deagle205/Whoop_1S_FC/Phil_stack_print.stl

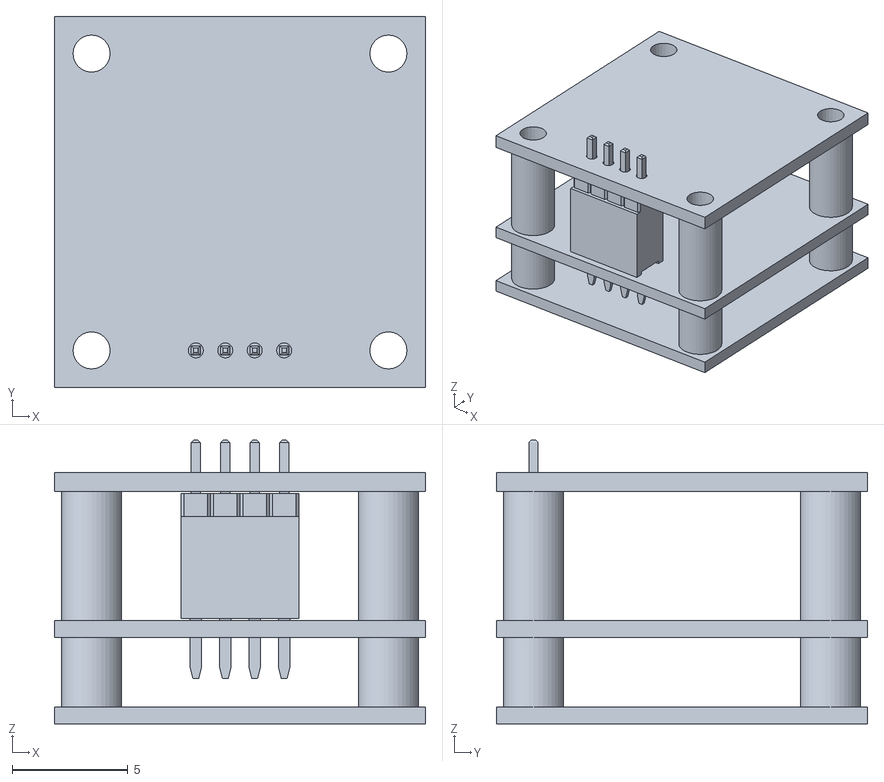
[picture p1: CAD file, 2026-10-23]
Phil_stack_print.stl
16.0 x 16.0 x 12.2
