deagle205/Whoop_1S_FC/Whoop_1S_FC_print.stl

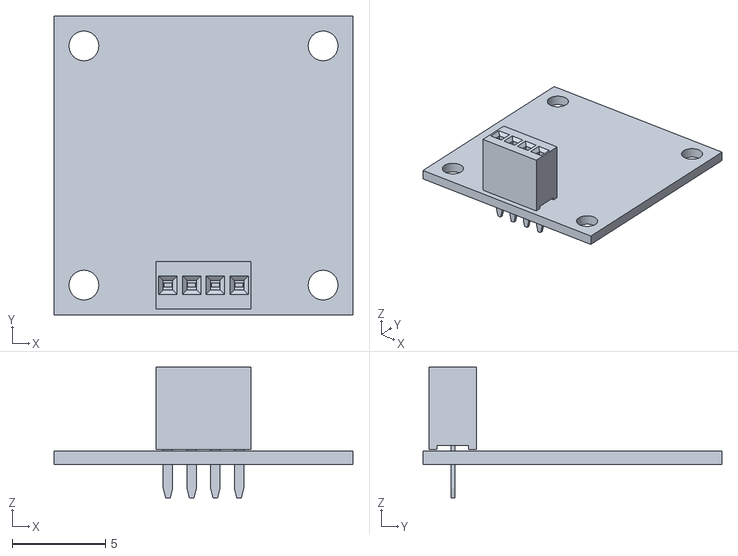
[picture p2: CAD file, 2026-10-23]
Whoop_1S_FC_print.stl
16.0 x 16.0 x 7.00
