deagle205/Whoop_1S_FC/Phil_VTX/Phil_VTX.kicad_pcb

## KiCad design Phil_VTX/Phil_VTX.kicad_pcb (2026-10-23)

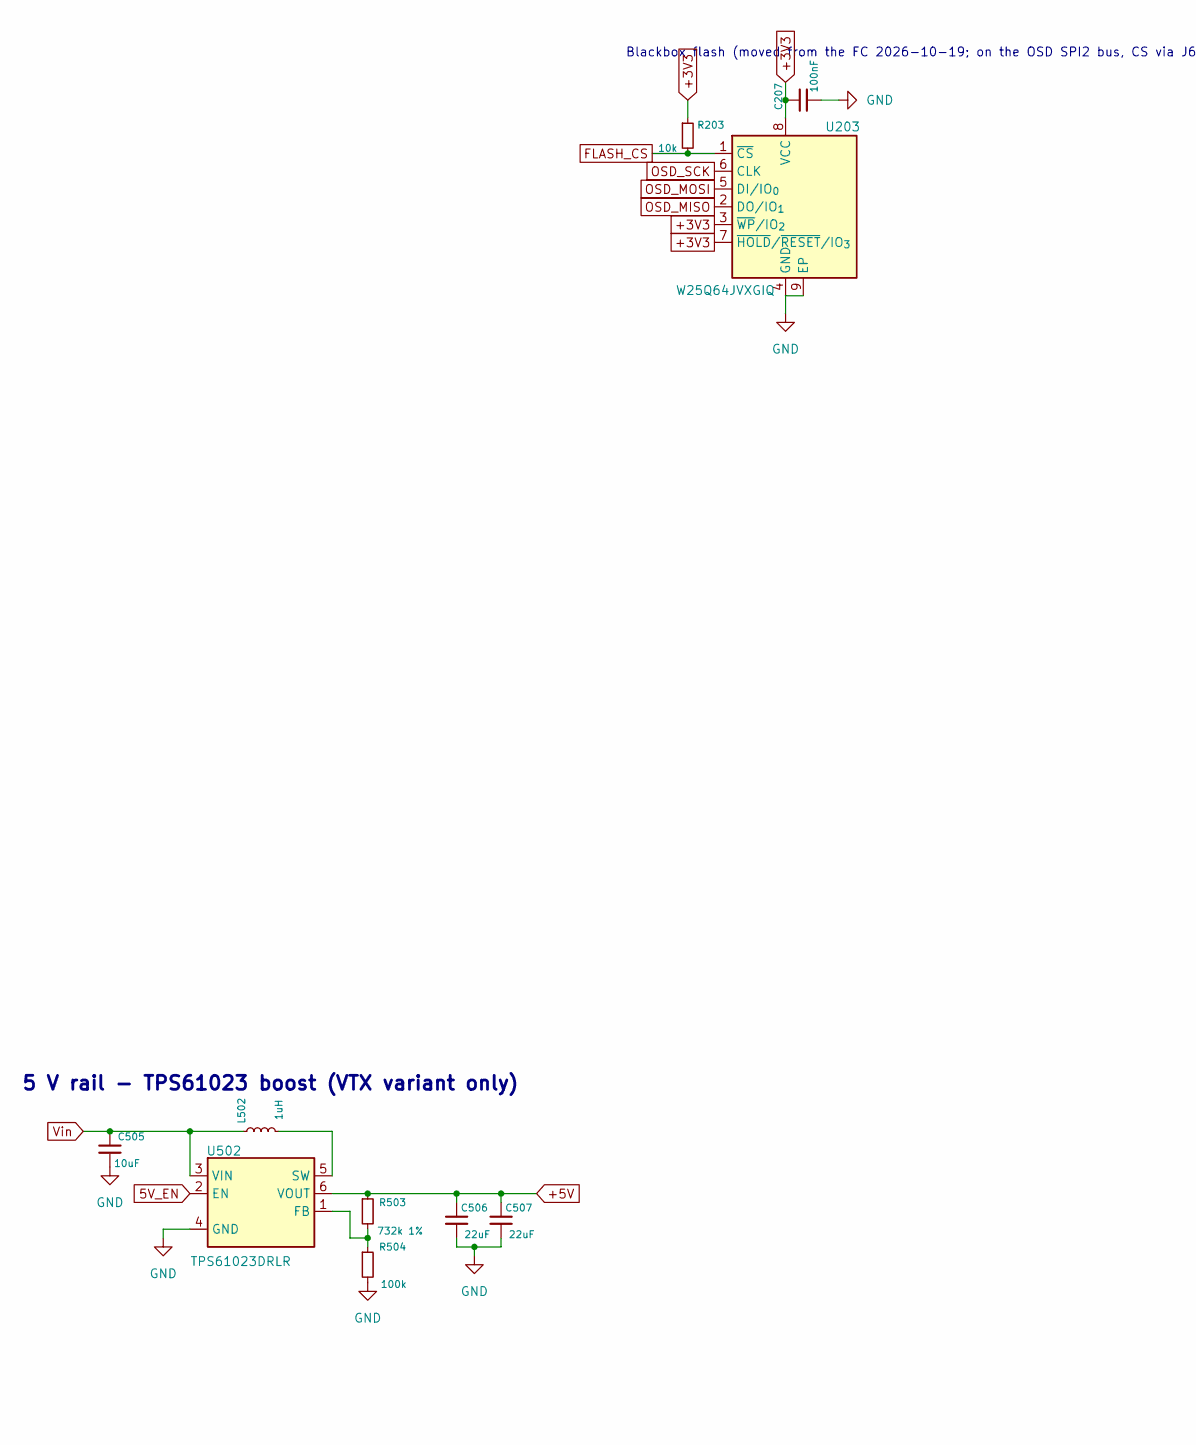
[picture p3: schematic Phil_VTX.kicad_sch, Phil VTX board (5.8 GHz VTX + OSD), part in row 1, column 1]

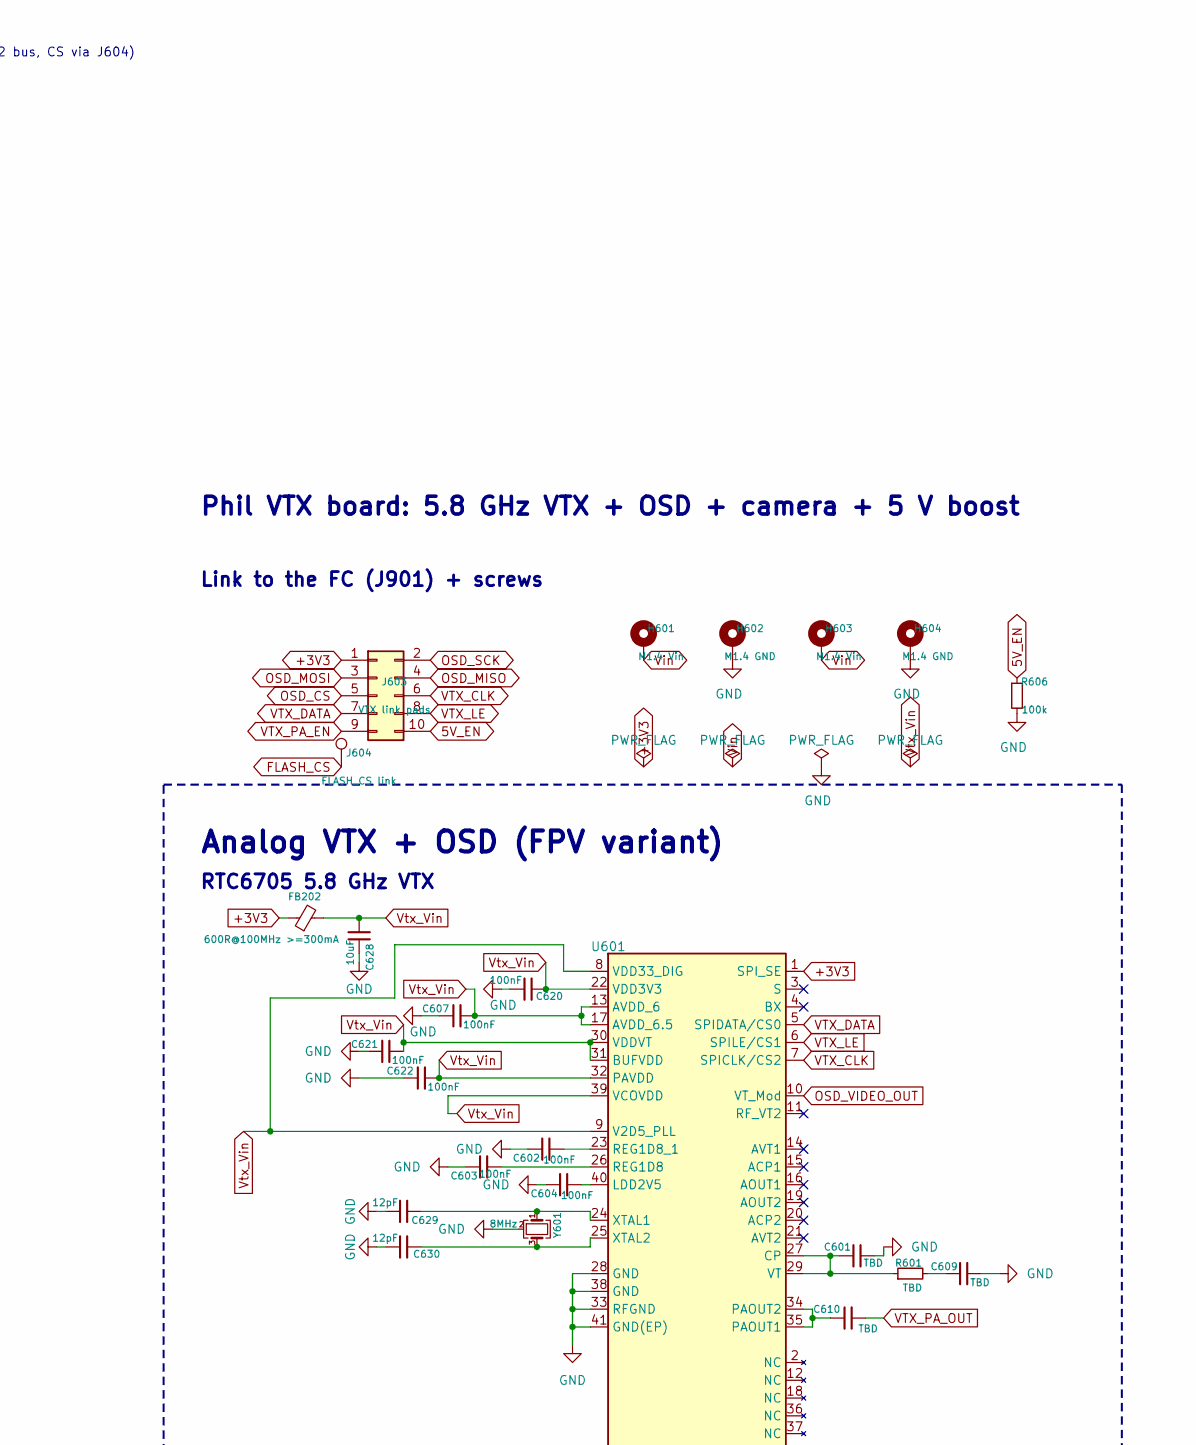
[picture p4: schematic Phil_VTX.kicad_sch, Phil VTX board (5.8 GHz VTX + OSD), part in row 1, column 2]

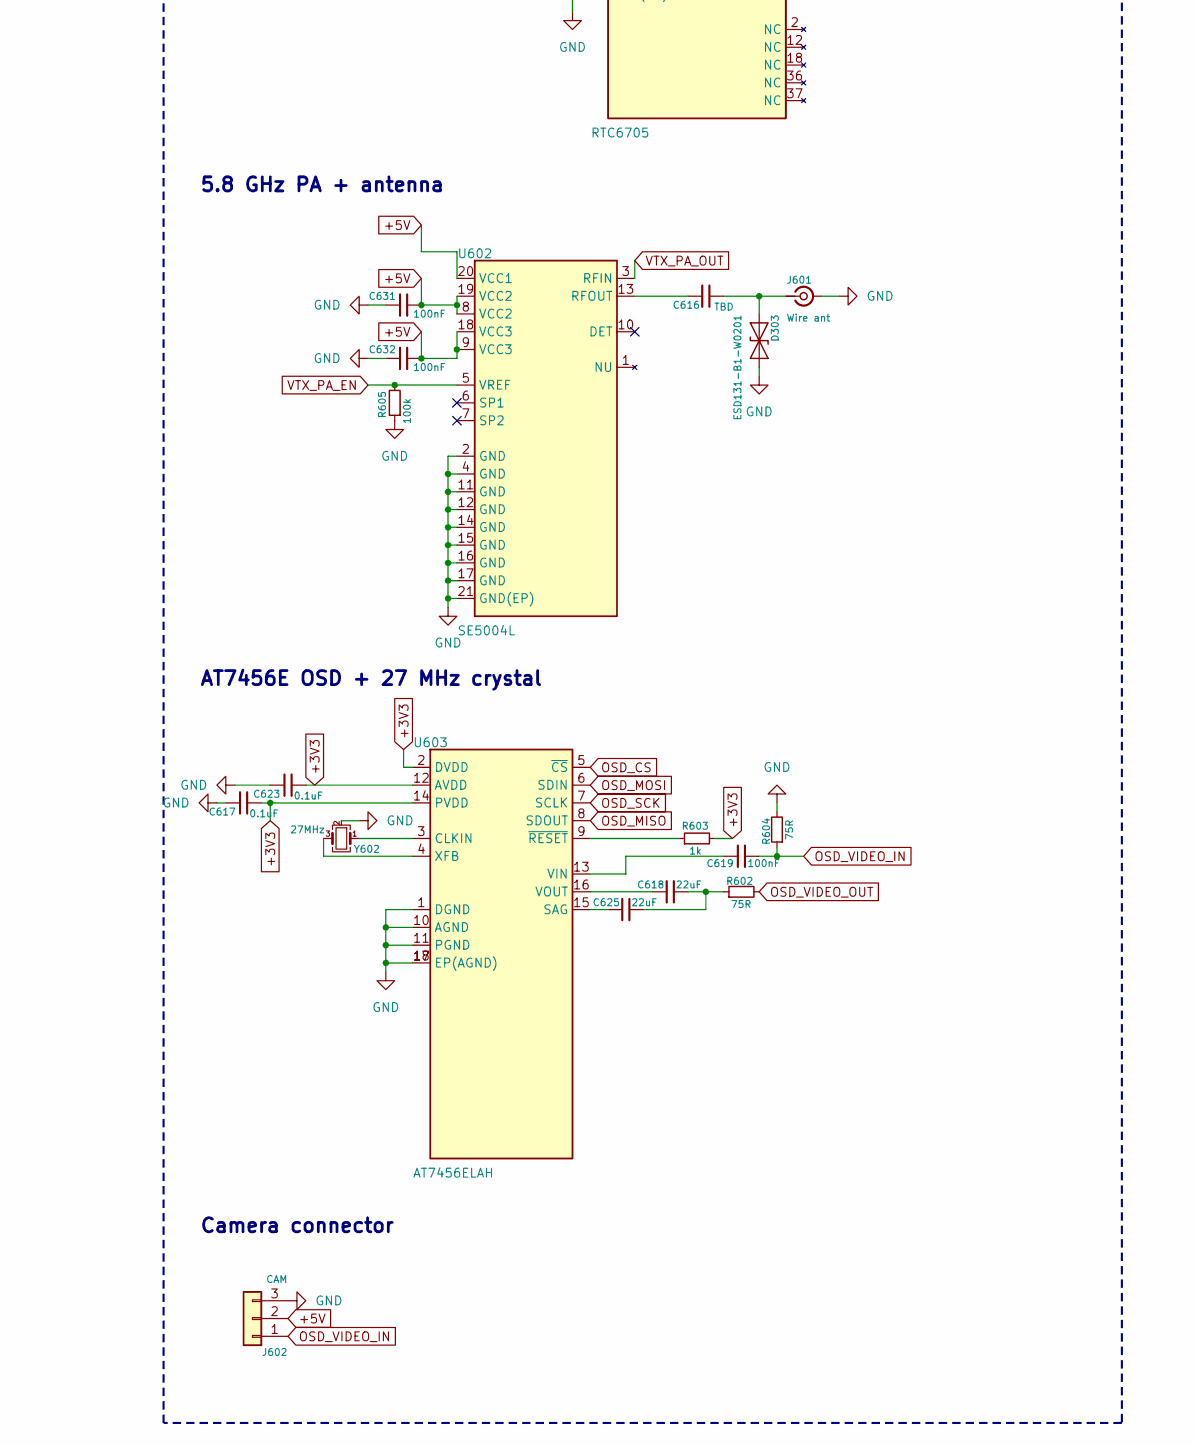
[picture p5: schematic Phil_VTX.kicad_sch, Phil VTX board (5.8 GHz VTX + OSD), part in row 2, column 2]

Parts:
C207, C602, C603, C604, C607, C619, C620, C621, C622, C631, C632: 100nF; C_0201_0603Metric; MPN CL03A104KQ3NNNC; LCSC C160831
C505, C628: 10uF; C_0603_1608Metric; MPN CL10A106KP8NNNC; LCSC C19702
C506, C507, C618, C625: 22uF; C_0603_1608Metric; MPN CL10A226MP8NUNE; LCSC C86295
C601, C609, C610, C616: TBD; C_0201_0603Metric
C617, C623: 0.1uF; C_0201_0603Metric; MPN CL03A104KQ3NNNC; LCSC C160831
C629, C630: 12pF; C_0201_0603Metric; MPN GRM0335C1H120JA01D; LCSC C85890
D303: ESD131-B1-W0201; Infineon_SG-WLL-2-3_0.58x0.28_P0.36mm; MPN ESD131-B1-W0201
FB202: 600R@100MHz >=300mA; L_0603_1608Metric
H601, H603: M1.4 Vin; MountingHole_1.6mm_M1.4_Pad_2.6mm
H602, H604: M1.4 GND; MountingHole_1.6mm_M1.4_Pad_2.6mm
J601: Wire ant; Antenna_Wire_Hole_D0.6mm
J602: CAM; Pads_1x03_P2.0mm_1.5x2.0mm; MPN SM03B-SRSS-TB
J603: VTX link pads; Pads_2x05_P1.8mm_1.5x2.0mm_Mirrored
J604: FLASH_CS link; TP_Wire_1.5x2.0mm
L502: 1uH; L_Murata_DFE201610P
R203: 10k; R_0201_0603Metric; MPN RC0201FR-0710KL; LCSC C106225
R503: 732k 1%; R_0201_0603Metric; MPN AA0201FR-07732KL; LCSC C2106378
R504, R605, R606: 100k; R_0201_0603Metric; MPN 0201WMF1003TEE; LCSC C270364
R601: TBD; R_0201_0603Metric
R602, R604: 75R; R_0201_0603Metric; MPN 0201WMF750JTCE; LCSC C270688
R603: 1k; R_0201_0603Metric; MPN 0201WMF1001TEE; LCSC C270365
U203: W25Q64JVXGIQ; Winbond_XSON-8-1EP_4x4mm_P0.8mm_EP2.3x3mm; MPN W25Q64JVXGIQ
U502: TPS61023DRLR; SOT-563; MPN TPS61023DRLR
U601: RTC6705; QFN-40-1EP_6x6mm_P0.5mm_EP4.6x4.6mm; MPN RTC6705
U602: SE5004L; QFN-20-1EP_4x4mm_P0.5mm_EP2.5x2.5mm; MPN SE5004L
U603: AT7456ELAH; AT7456E_LGA-16_4x6.8mm_P0.65mm; MPN AT7456E
Y601: 8MHz; Crystal_SMD_2016-4Pin_2.0x1.6mm
Y602: 27MHz; Crystal_SMD_WE_IQXC-26-4Pin_1.6x1.2mm

Connections:
5V_EN: J603.10, R606.1, U502.2 (EN)
+3V3: C207.1, C617.2, C623.2, FB202.1, J603.1, R203.1, R603.2, U203.3 (~WP/IO_{2}), U203.7 (~HOLD/~RESET/IO_{3}), U203.8 (VCC), U601.1 (SPI_SE), U603.2 (DVDD), U603.12 (AVDD), U603.14 (PVDD)
+5V: C506.1, C507.1, C631.2, C632.2, J602.2, R503.1, U502.6 (VOUT), U602.8 (VCC2), U602.9 (VCC3), U602.18 (VCC3), U602.19 (VCC2), U602.20 (VCC1)
GND: C207.2, C505.2, C506.2, C507.2, C601.2, C602.1, C603.1, C604.1, C607.1, C609.2, C617.1, C620.2, C621.1, C622.1, C623.1, C628.2, C629.2, C630.2, C631.1, C632.1, D303.2 (A2), H602.1, H604.1, J601.2 (Ext), J602.3, R504.2, R604.2, R605.1, R606.2, U203.4 (GND), U203.9 (EP), U502.4 (GND), U601.28 (GND), U601.33 (RFGND), U601.38 (GND), U601.41 (GND(EP)), U602.2 (GND), U602.4 (GND), U602.11 (GND), U602.12 (GND), U602.14 (GND), U602.15 (GND), U602.16 (GND), U602.17 (GND), U602.21 (GND(EP)), U603.1 (DGND), U603.10 (AGND), U603.11 (PGND), U603.17 (EP(AGND)), U603.18 (EP(AGND)), Y601.2 (G), Y601.4 (G), Y602.2 (G), Y602.4 (G)
unnamed: C609.1, R601.2
unnamed: C618.2, C625.2, R602.1
unnamed: C616.2, D303.1 (A1), J601.1 (In)
unnamed: J604.1, R203.2, U203.1 (~CS)
unnamed: R503.2, R504.1, U502.1 (FB)
unnamed: L502.2, U502.5 (SW)
unnamed: C601.1, R601.1, U601.27 (CP), U601.29 (VT)
unnamed: C604.2, U601.40 (LDD2V5)
unnamed: C610.1, U601.34 (PAOUT2), U601.35 (PAOUT1)
unnamed: C603.2, U601.26 (REG1D8)
unnamed: C602.2, U601.23 (REG1D8_1)
unnamed: C629.1, U601.24 (XTAL1), Y601.1
unnamed: C630.1, U601.25 (XTAL2), Y601.3
unnamed: C616.1, U602.13 (RFOUT)
unnamed: U603.3 (CLKIN), Y602.1
unnamed: C625.1, U603.15 (SAG)
unnamed: C619.1, U603.13 (VIN)
unnamed: C618.1, U603.16 (VOUT)
unnamed: U603.4 (XFB), Y602.3
unnamed: R603.1, U603.9 (~RESET)
OSD_CS: J603.5, U603.5 (~CS)
OSD_MISO: J603.4, U203.2 (DO/IO_{1}), U603.8 (SDOUT)
OSD_MOSI: J603.3, U203.5 (DI/IO_{0}), U603.6 (SDIN)
OSD_SCK: J603.2, U203.6 (CLK), U603.7 (SCLK)
OSD_VIDEO_IN: C619.2, J602.1, R604.1
OSD_VIDEO_OUT: R602.2, U601.10 (VT_Mod)
VTX_CLK: J603.6, U601.7 (SPICLK/CS2)
VTX_DATA: J603.7, U601.5 (SPIDATA/CS0)
VTX_LE: J603.8, U601.6 (SPILE/CS1)
VTX_PA_EN: J603.9, R605.2, U602.5 (VREF)
VTX_PA_OUT: C610.2, U602.3 (RFIN)
Vin: C505.1, H601.1, H603.1, L502.1, U502.3 (VIN)
Vtx_Vin: C607.2, C620.1, C621.2, C622.2, C628.1, FB202.2, U601.8 (VDD33_DIG), U601.9 (V2D5_PLL), U601.13 (AVDD_6), U601.17 (AVDD_6.5), U601.22 (VDD3V3), U601.30 (VDDVT), U601.31 (BUFVDD), U601.32 (PAVDD), U601.39 (VCOVDD)

Notes on the sheet:
5 V rail - TPS61023 boost (VTX variant only)
5.8 GHz PA + antenna
RTC6705 5.8 GHz VTX
Blackbox flash (moved from the FC 2026-10-19; on the OSD SPI2 bus, CS via J604)
Phil VTX board: 5.8 GHz VTX + OSD + camera + 5 V boost
Link to the FC (J901) + screws
AT7456E OSD + 27 MHz crystal
Camera connector
Analog VTX + OSD (FPV variant)

Board: 6 copper layers, 48 parts (0 on the bottom side), 36 nets, no tracks yet.
