deagle205/Whoop_1S_FC/Phil_ESC/Phil_ESC.kicad_pcb

## KiCad design Phil_ESC/Phil_ESC.kicad_pcb (2026-10-23)

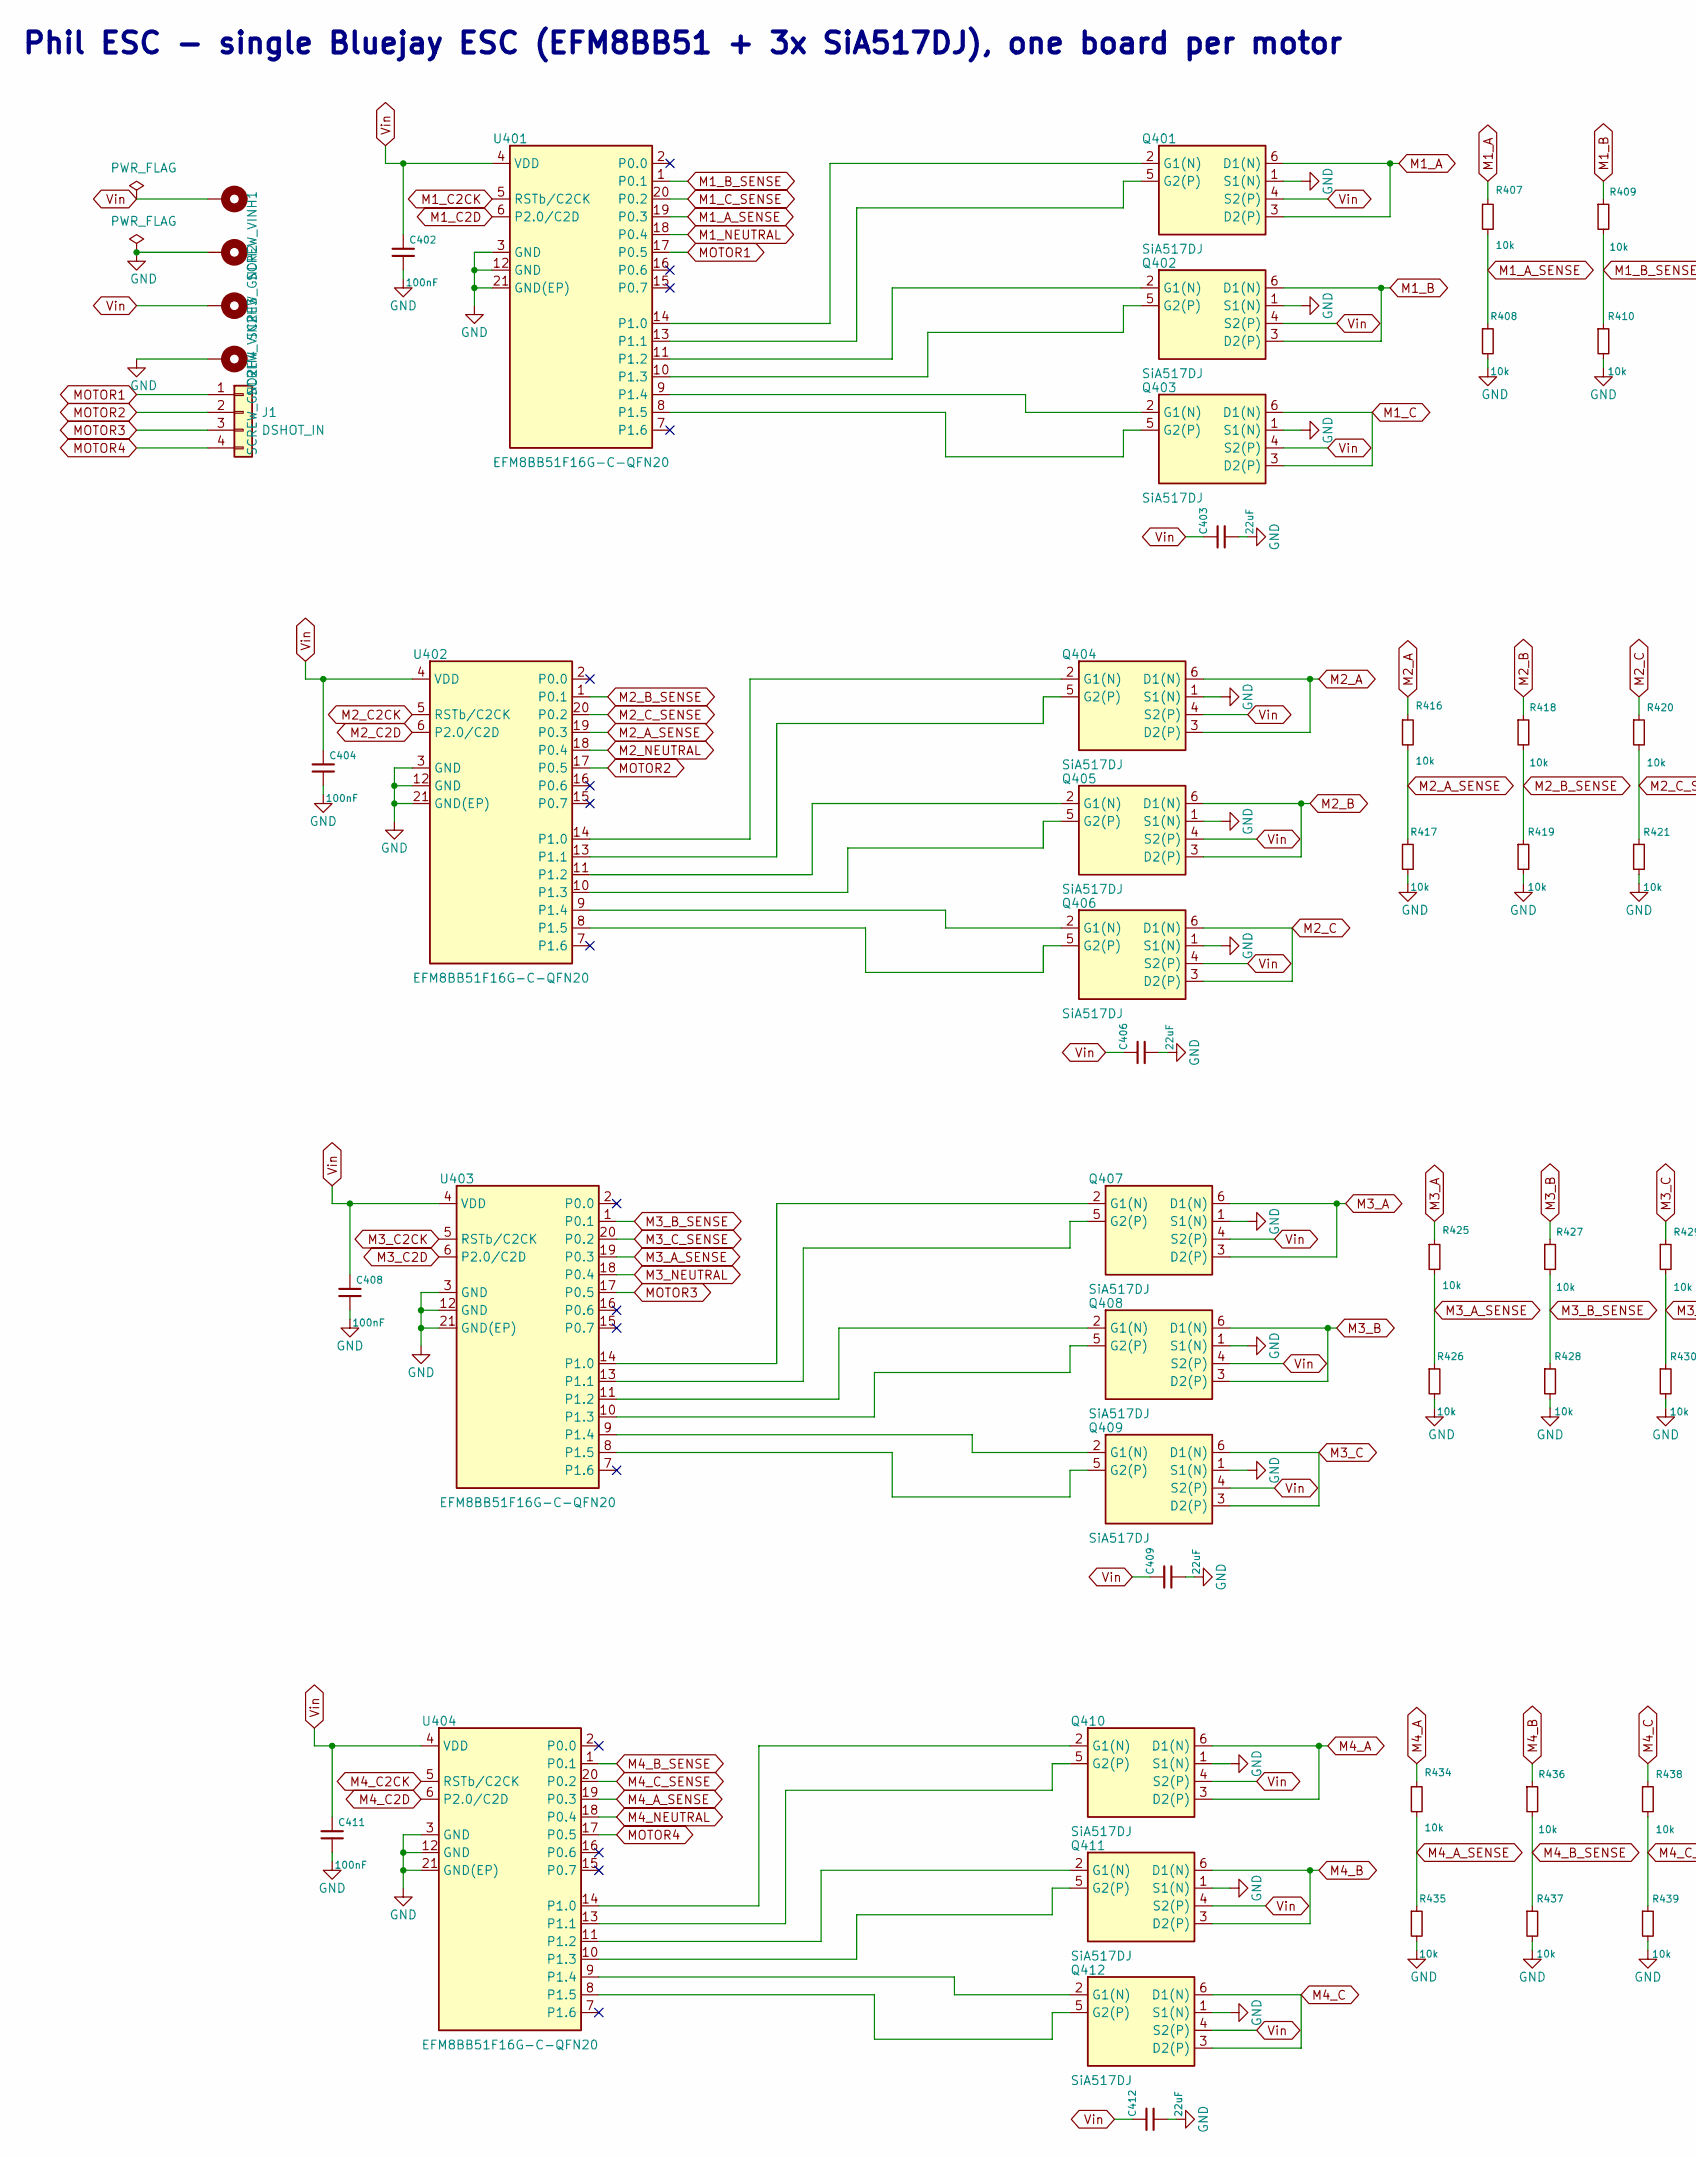
[picture p6: schematic Phil_ESC.kicad_sch, Phil ESC - single-motor Bluejay ESC, part in row 1, column 1]

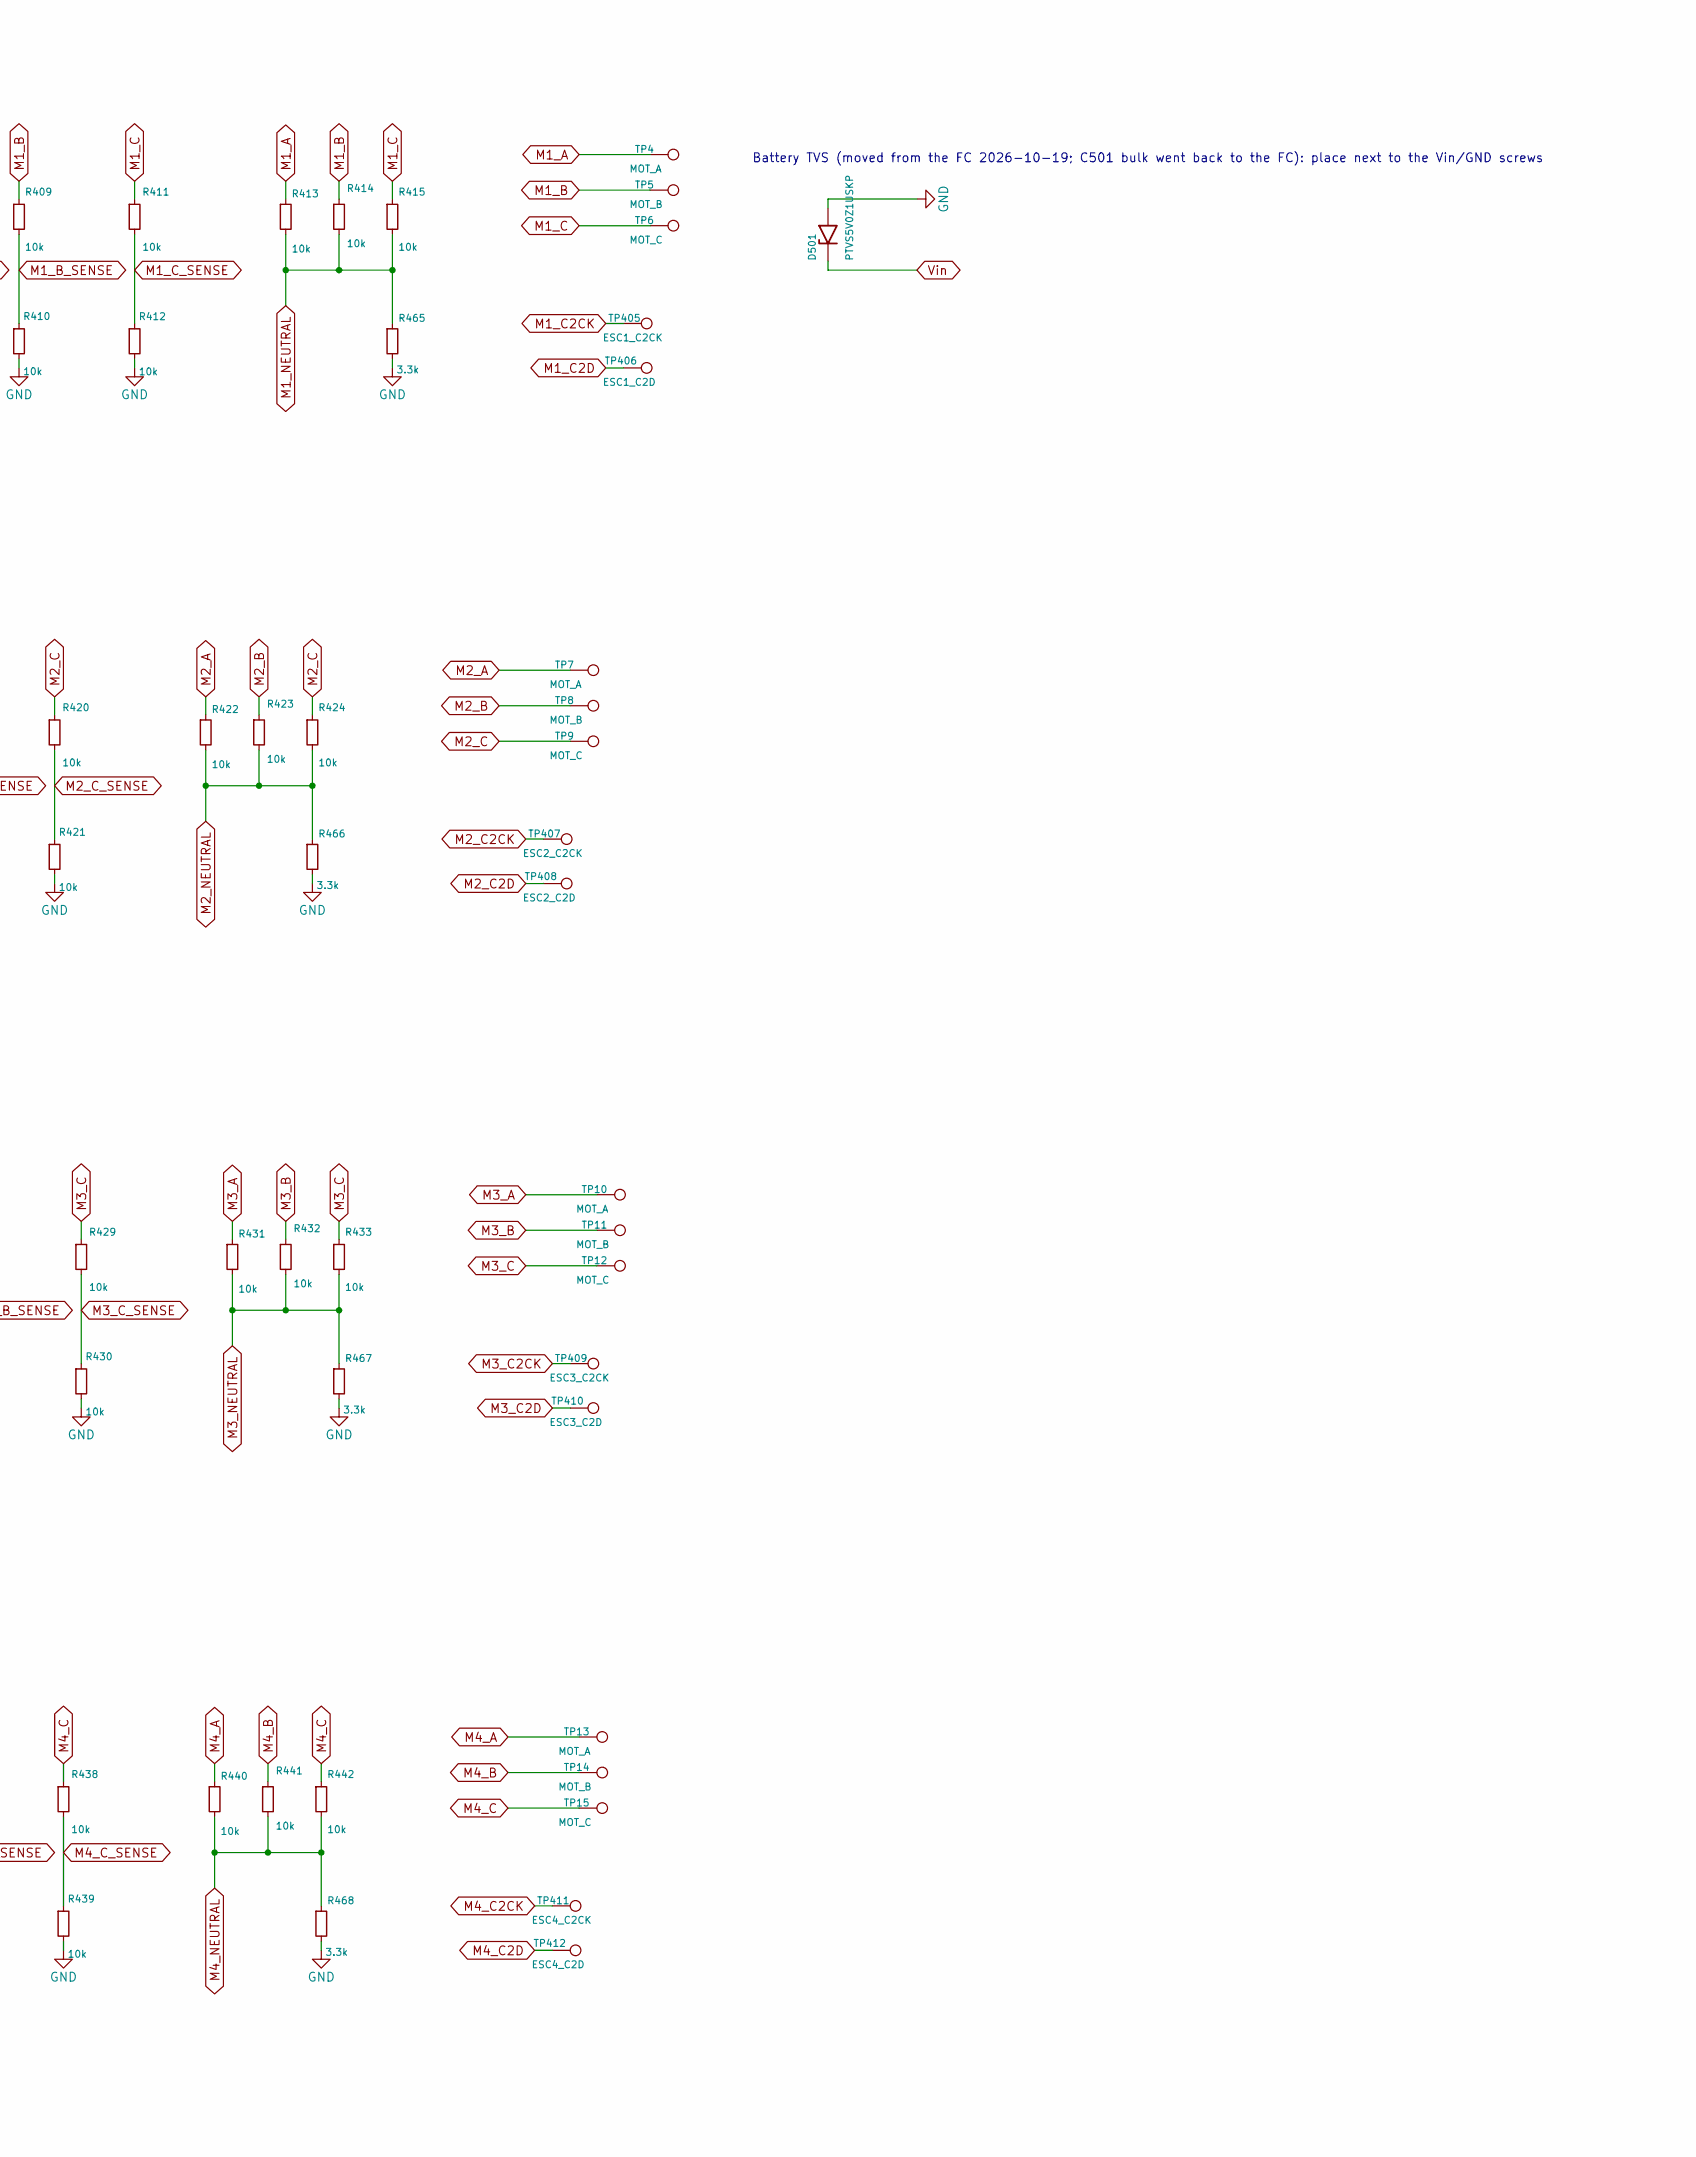
[picture p7: schematic Phil_ESC.kicad_sch, Phil ESC - single-motor Bluejay ESC, part in row 1, column 2]

Parts:
C402, C404, C408, C411: 100nF; C_0201_0603Metric; MPN CL03A104KQ3NNNC; LCSC C160831
C403, C406, C409, C412: 22uF; C_0603_1608Metric; MPN CL10A226MP8NUNE; LCSC C86295
D501: PTVS5V0Z1USKP; Nexperia_DSN1608-2_1.6x0.8mm; MPN PTVS5V0Z1USKP
H1: SCREW_VIN; MountingHole_1.6mm_M1.4_Pad_2.6mm
H2: SCREW_GND; MountingHole_1.6mm_M1.4_Pad_2.6mm
H3: SCREW_VIN2; MountingHole_1.6mm_M1.4_Pad_2.6mm
H4: SCREW_GND2; MountingHole_1.6mm_M1.4_Pad_2.6mm
J1: DSHOT_IN; PinHeader_1x04_P1.27mm_Vertical
Q401, Q402, Q403, Q404, Q405, Q406, Q407, Q408, Q409, Q410, Q411, Q412: SiA517DJ; Vishay_PowerPAK_SC70-6L_Dual; MPN SIA517DJ-T1-GE3
R407, R408, R409, R410, R411, R412, R413, R414, R415, R416, R417, R418, R419, R420, R421, R422, R423, R424, R425, R426, R427, R428, R429, R430, R431, R432, R433, R434, R435, R436, R437, R438, R439, R440, R441, R442: 10k; R_0201_0603Metric; MPN RC0201FR-0710KL; LCSC C106225
R465, R466, R467, R468: 3.3k; R_0201_0603Metric; MPN RC0201FR-073K3L; LCSC C274874
TP4, TP7, TP10, TP13: MOT_A; TP_Motor_1.5x1.5mm
TP5, TP8, TP11, TP14: MOT_B; TP_Motor_1.5x1.5mm
TP6, TP9, TP12, TP15: MOT_C; TP_Motor_1.5x1.5mm
TP405: ESC1_C2CK; TP_Probe_D0.6mm
TP406: ESC1_C2D; TP_Probe_D0.6mm
TP407: ESC2_C2CK; TP_Probe_D0.6mm
TP408: ESC2_C2D; TP_Probe_D0.6mm
TP409: ESC3_C2CK; TP_Probe_D0.6mm
TP410: ESC3_C2D; TP_Probe_D0.6mm
TP411: ESC4_C2CK; TP_Probe_D0.6mm
TP412: ESC4_C2D; TP_Probe_D0.6mm
U401, U402, U403, U404: EFM8BB51F16G-C-QFN20; SiliconLabs_QFN-20-1EP_3x3mm_P0.5mm_EP1.8x1.8mm; MPN EFM8BB51F16G-C-QFN20

Connections:
GND: C402.2, C403.2, C404.2, C406.2, C408.2, C409.2, C411.2, C412.2, D501.2 (A2), H2.1 (1_1), H4.1 (1_1), Q401.1 (S1(N)), Q402.1 (S1(N)), Q403.1 (S1(N)), Q404.1 (S1(N)), Q405.1 (S1(N)), Q406.1 (S1(N)), Q407.1 (S1(N)), Q408.1 (S1(N)), Q409.1 (S1(N)), Q410.1 (S1(N)), Q411.1 (S1(N)), Q412.1 (S1(N)), R408.2, R410.2, R412.2, R417.2, R419.2, R421.2, R426.2, R428.2, R430.2, R435.2, R437.2, R439.2, R465.2, R466.2, R467.2, R468.2, U401.3 (GND), U401.12 (GND), U401.21 (GND(EP)), U402.3 (GND), U402.12 (GND), U402.21 (GND(EP)), U403.3 (GND), U403.12 (GND), U403.21 (GND(EP)), U404.3 (GND), U404.12 (GND), U404.21 (GND(EP))
M1_A: Q401.3 (D2(P)), Q401.6 (D1(N)), R407.1, R413.1, TP4.1 (1_1)
M1_A_SENSE: R407.2, R408.1, U401.19 (P0.3)
M1_B: Q402.3 (D2(P)), Q402.6 (D1(N)), R409.1, R414.1, TP5.1 (1_1)
M1_B_SENSE: R409.2, R410.1, U401.1 (P0.1)
M1_C: Q403.3 (D2(P)), Q403.6 (D1(N)), R411.1, R415.1, TP6.1 (1_1)
M1_C2CK: TP405.1 (1_1), U401.5 (RSTb/C2CK)
M1_C2D: TP406.1 (1_1), U401.6 (P2.0/C2D)
M1_C_SENSE: R411.2, R412.1, U401.20 (P0.2)
M1_NEUTRAL: R413.2, R414.2, R415.2, R465.1, U401.18 (P0.4)
M2_A: Q404.3 (D2(P)), Q404.6 (D1(N)), R416.1, R422.1, TP7.1 (1_1)
M2_A_SENSE: R416.2, R417.1, U402.19 (P0.3)
M2_B: Q405.3 (D2(P)), Q405.6 (D1(N)), R418.1, R423.1, TP8.1 (1_1)
M2_B_SENSE: R418.2, R419.1, U402.1 (P0.1)
M2_C: Q406.3 (D2(P)), Q406.6 (D1(N)), R420.1, R424.1, TP9.1 (1_1)
M2_C2CK: TP407.1 (1_1), U402.5 (RSTb/C2CK)
M2_C2D: TP408.1 (1_1), U402.6 (P2.0/C2D)
M2_C_SENSE: R420.2, R421.1, U402.20 (P0.2)
M2_NEUTRAL: R422.2, R423.2, R424.2, R466.1, U402.18 (P0.4)
M3_A: Q407.3 (D2(P)), Q407.6 (D1(N)), R425.1, R431.1, TP10.1 (1_1)
M3_A_SENSE: R425.2, R426.1, U403.19 (P0.3)
M3_B: Q408.3 (D2(P)), Q408.6 (D1(N)), R427.1, R432.1, TP11.1 (1_1)
M3_B_SENSE: R427.2, R428.1, U403.1 (P0.1)
M3_C: Q409.3 (D2(P)), Q409.6 (D1(N)), R429.1, R433.1, TP12.1 (1_1)
M3_C2CK: TP409.1 (1_1), U403.5 (RSTb/C2CK)
M3_C2D: TP410.1 (1_1), U403.6 (P2.0/C2D)
M3_C_SENSE: R429.2, R430.1, U403.20 (P0.2)
M3_NEUTRAL: R431.2, R432.2, R433.2, R467.1, U403.18 (P0.4)
M4_A: Q410.3 (D2(P)), Q410.6 (D1(N)), R434.1, R440.1, TP13.1 (1_1)
M4_A_SENSE: R434.2, R435.1, U404.19 (P0.3)
M4_B: Q411.3 (D2(P)), Q411.6 (D1(N)), R436.1, R441.1, TP14.1 (1_1)
M4_B_SENSE: R436.2, R437.1, U404.1 (P0.1)
M4_C: Q412.3 (D2(P)), Q412.6 (D1(N)), R438.1, R442.1, TP15.1 (1_1)
M4_C2CK: TP411.1 (1_1), U404.5 (RSTb/C2CK)
M4_C2D: TP412.1 (1_1), U404.6 (P2.0/C2D)
M4_C_SENSE: R438.2, R439.1, U404.20 (P0.2)
M4_NEUTRAL: R440.2, R441.2, R442.2, R468.1, U404.18 (P0.4)
MOTOR1: J1.1, U401.17 (P0.5)
MOTOR2: J1.2, U402.17 (P0.5)
MOTOR3: J1.3, U403.17 (P0.5)
MOTOR4: J1.4, U404.17 (P0.5)
unnamed: Q401.2 (G1(N)), U401.14 (P1.0)
unnamed: Q401.5 (G2(P)), U401.13 (P1.1)
unnamed: Q402.2 (G1(N)), U401.11 (P1.2)
unnamed: Q402.5 (G2(P)), U401.10 (P1.3)
unnamed: Q403.2 (G1(N)), U401.9 (P1.4)
unnamed: Q403.5 (G2(P)), U401.8 (P1.5)
unnamed: Q404.2 (G1(N)), U402.14 (P1.0)
unnamed: Q404.5 (G2(P)), U402.13 (P1.1)
unnamed: Q405.2 (G1(N)), U402.11 (P1.2)
unnamed: Q405.5 (G2(P)), U402.10 (P1.3)
unnamed: Q406.2 (G1(N)), U402.9 (P1.4)
unnamed: Q406.5 (G2(P)), U402.8 (P1.5)
unnamed: Q407.2 (G1(N)), U403.14 (P1.0)
unnamed: Q407.5 (G2(P)), U403.13 (P1.1)
unnamed: Q408.2 (G1(N)), U403.11 (P1.2)
unnamed: Q408.5 (G2(P)), U403.10 (P1.3)
unnamed: Q409.2 (G1(N)), U403.9 (P1.4)
unnamed: Q409.5 (G2(P)), U403.8 (P1.5)
unnamed: Q410.2 (G1(N)), U404.14 (P1.0)
unnamed: Q410.5 (G2(P)), U404.13 (P1.1)
unnamed: Q411.2 (G1(N)), U404.11 (P1.2)
unnamed: Q411.5 (G2(P)), U404.10 (P1.3)
unnamed: Q412.2 (G1(N)), U404.9 (P1.4)
unnamed: Q412.5 (G2(P)), U404.8 (P1.5)
Vin: C402.1, C403.1, C404.1, C406.1, C408.1, C409.1, C411.1, C412.1, D501.1 (A1), H1.1 (1_1), H3.1 (1_1), Q401.4 (S2(P)), Q402.4 (S2(P)), Q403.4 (S2(P)), Q404.4 (S2(P)), Q405.4 (S2(P)), Q406.4 (S2(P)), Q407.4 (S2(P)), Q408.4 (S2(P)), Q409.4 (S2(P)), Q410.4 (S2(P)), Q411.4 (S2(P)), Q412.4 (S2(P)), U401.4 (VDD), U402.4 (VDD), U403.4 (VDD), U404.4 (VDD)

Notes on the sheet:
Phil ESC - single Bluejay ESC (EFM8BB51 + 3x SiA517DJ), one board per motor
Battery TVS (moved from the FC 2026-10-19; C501 bulk went back to the FC): place next to the Vin/GND screws

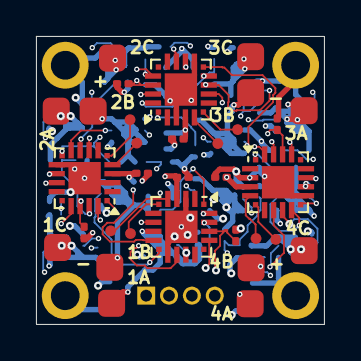
[picture p8: board Phil_ESC.kicad_pcb from above]

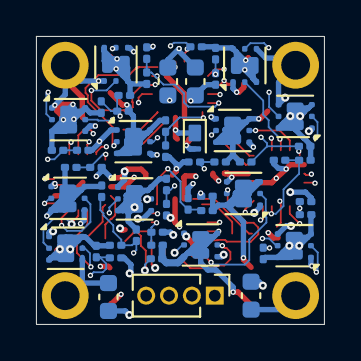
[picture p9: board Phil_ESC.kicad_pcb from below]

Board: 6 copper layers, 16.0 x 16.0 mm, 90 parts (54 on the bottom side), 66 nets.
