deagle205/Whoop_1S_FC/Whoop_1S_FC.kicad_pcb

## KiCad design Whoop_1S_FC.kicad_pcb (2026-10-23)

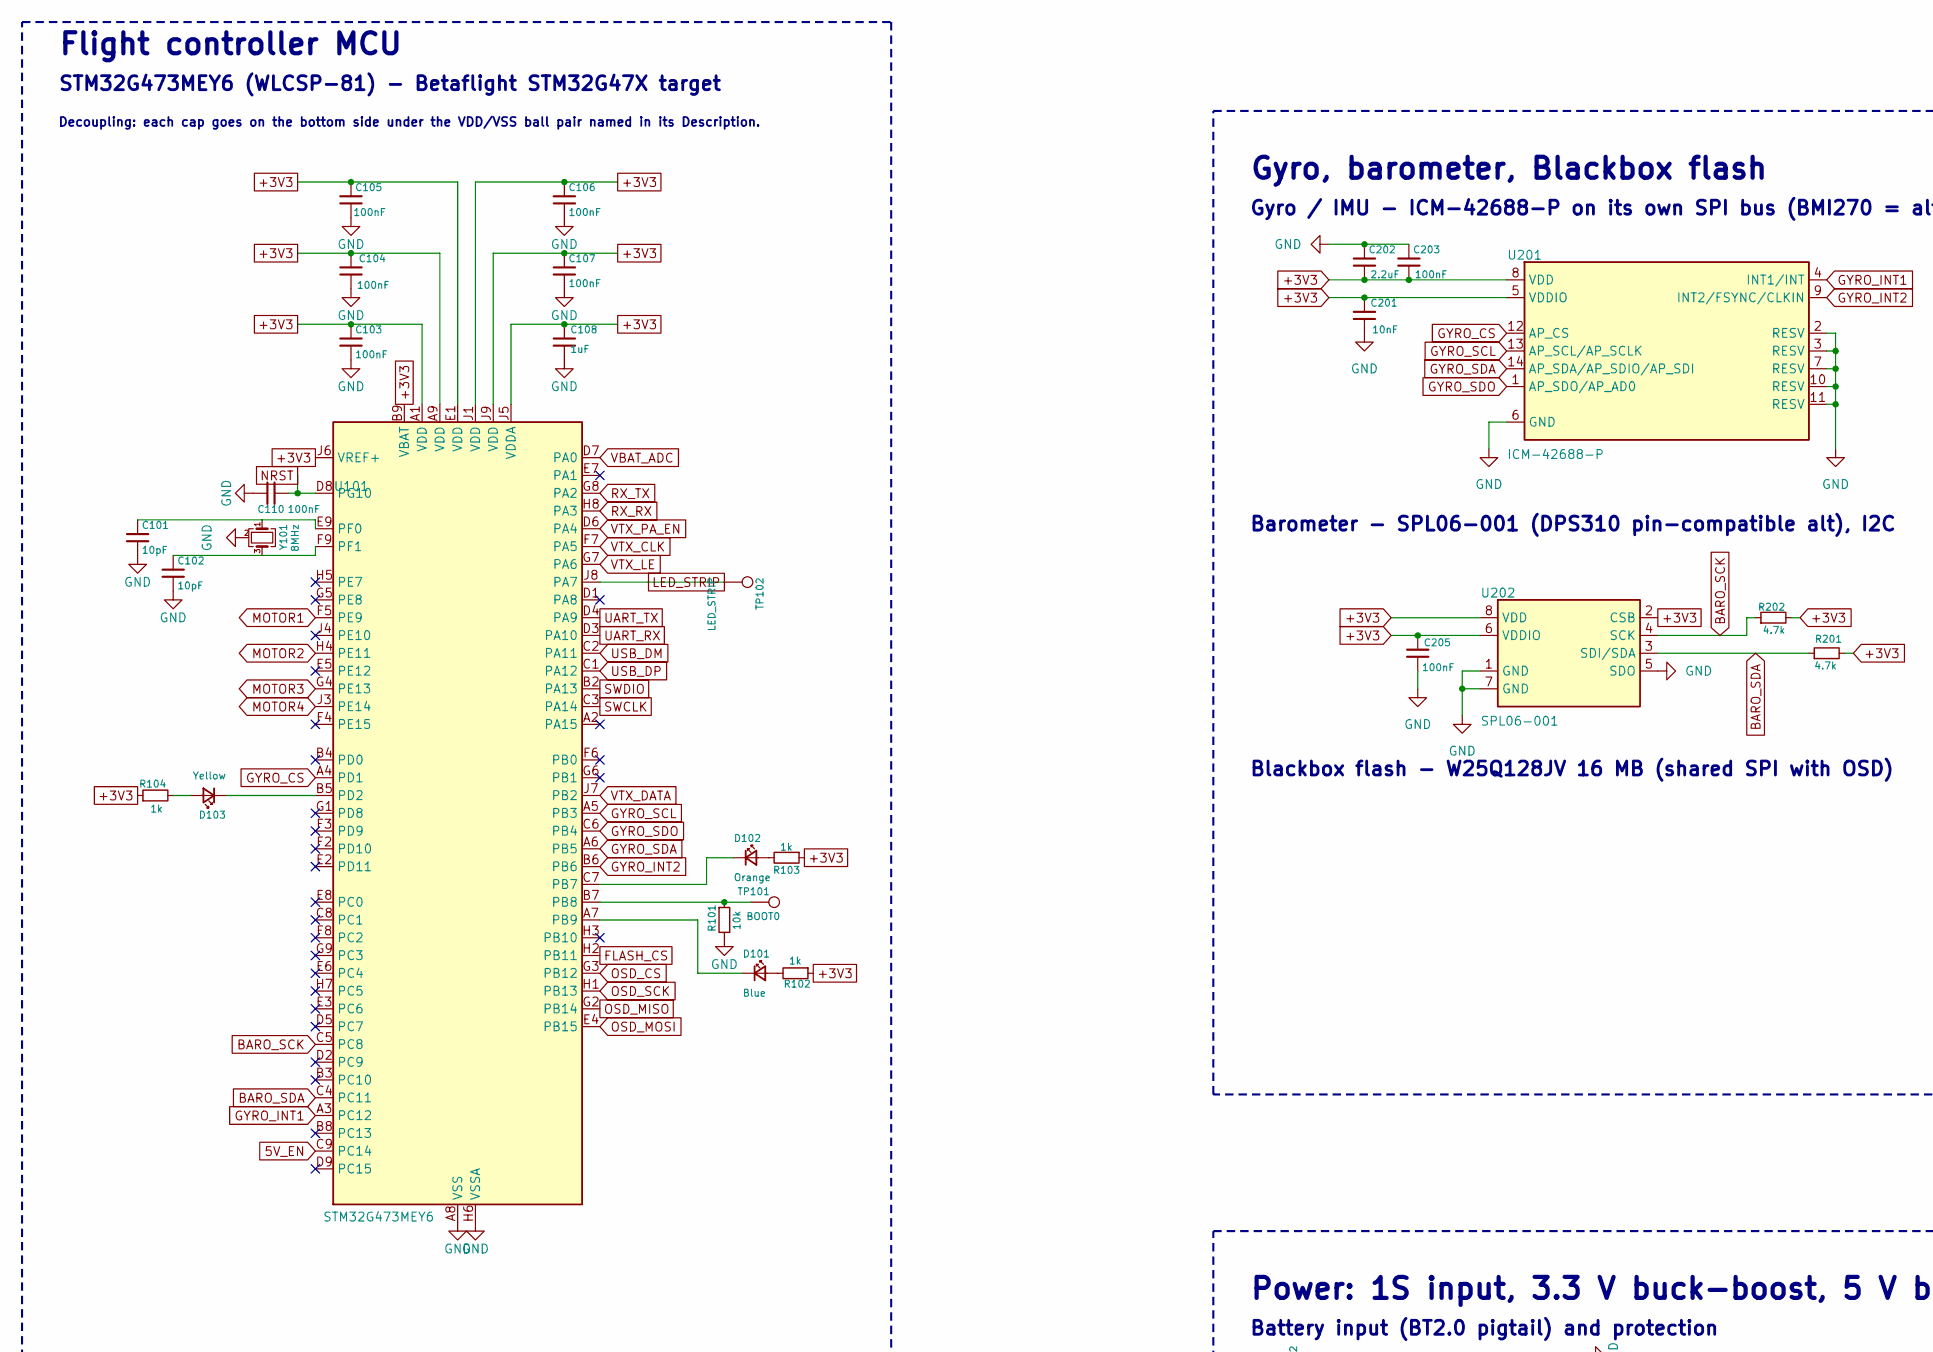
[picture p10: schematic Whoop_1S_FC.kicad_sch, 1S Whoop AIO Flight Controller, part in row 1, column 1]

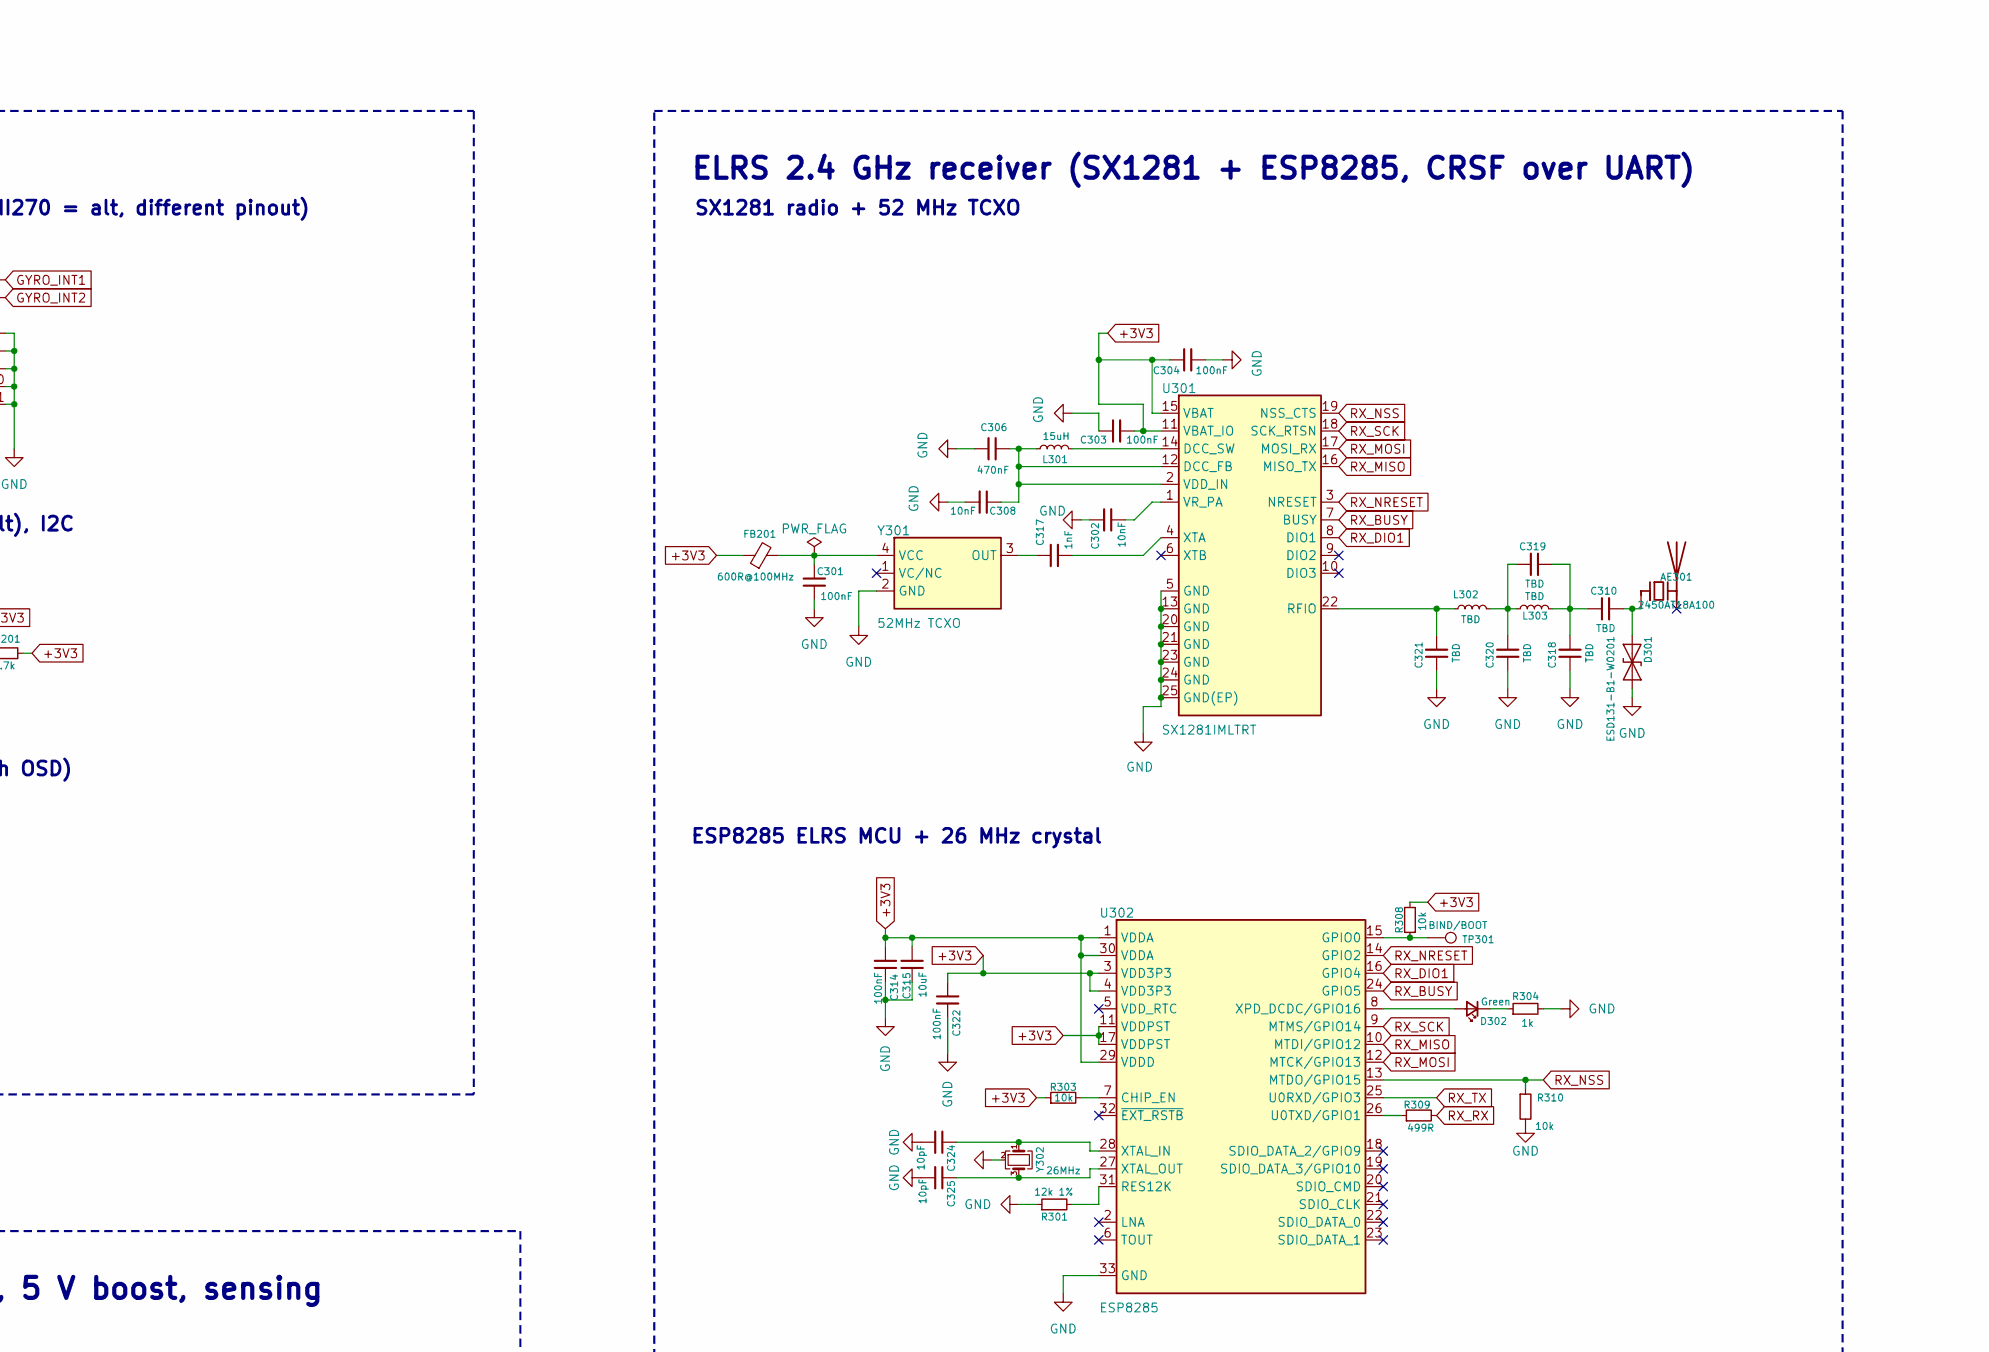
[picture p11: schematic Whoop_1S_FC.kicad_sch, 1S Whoop AIO Flight Controller, part in row 1, column 2]

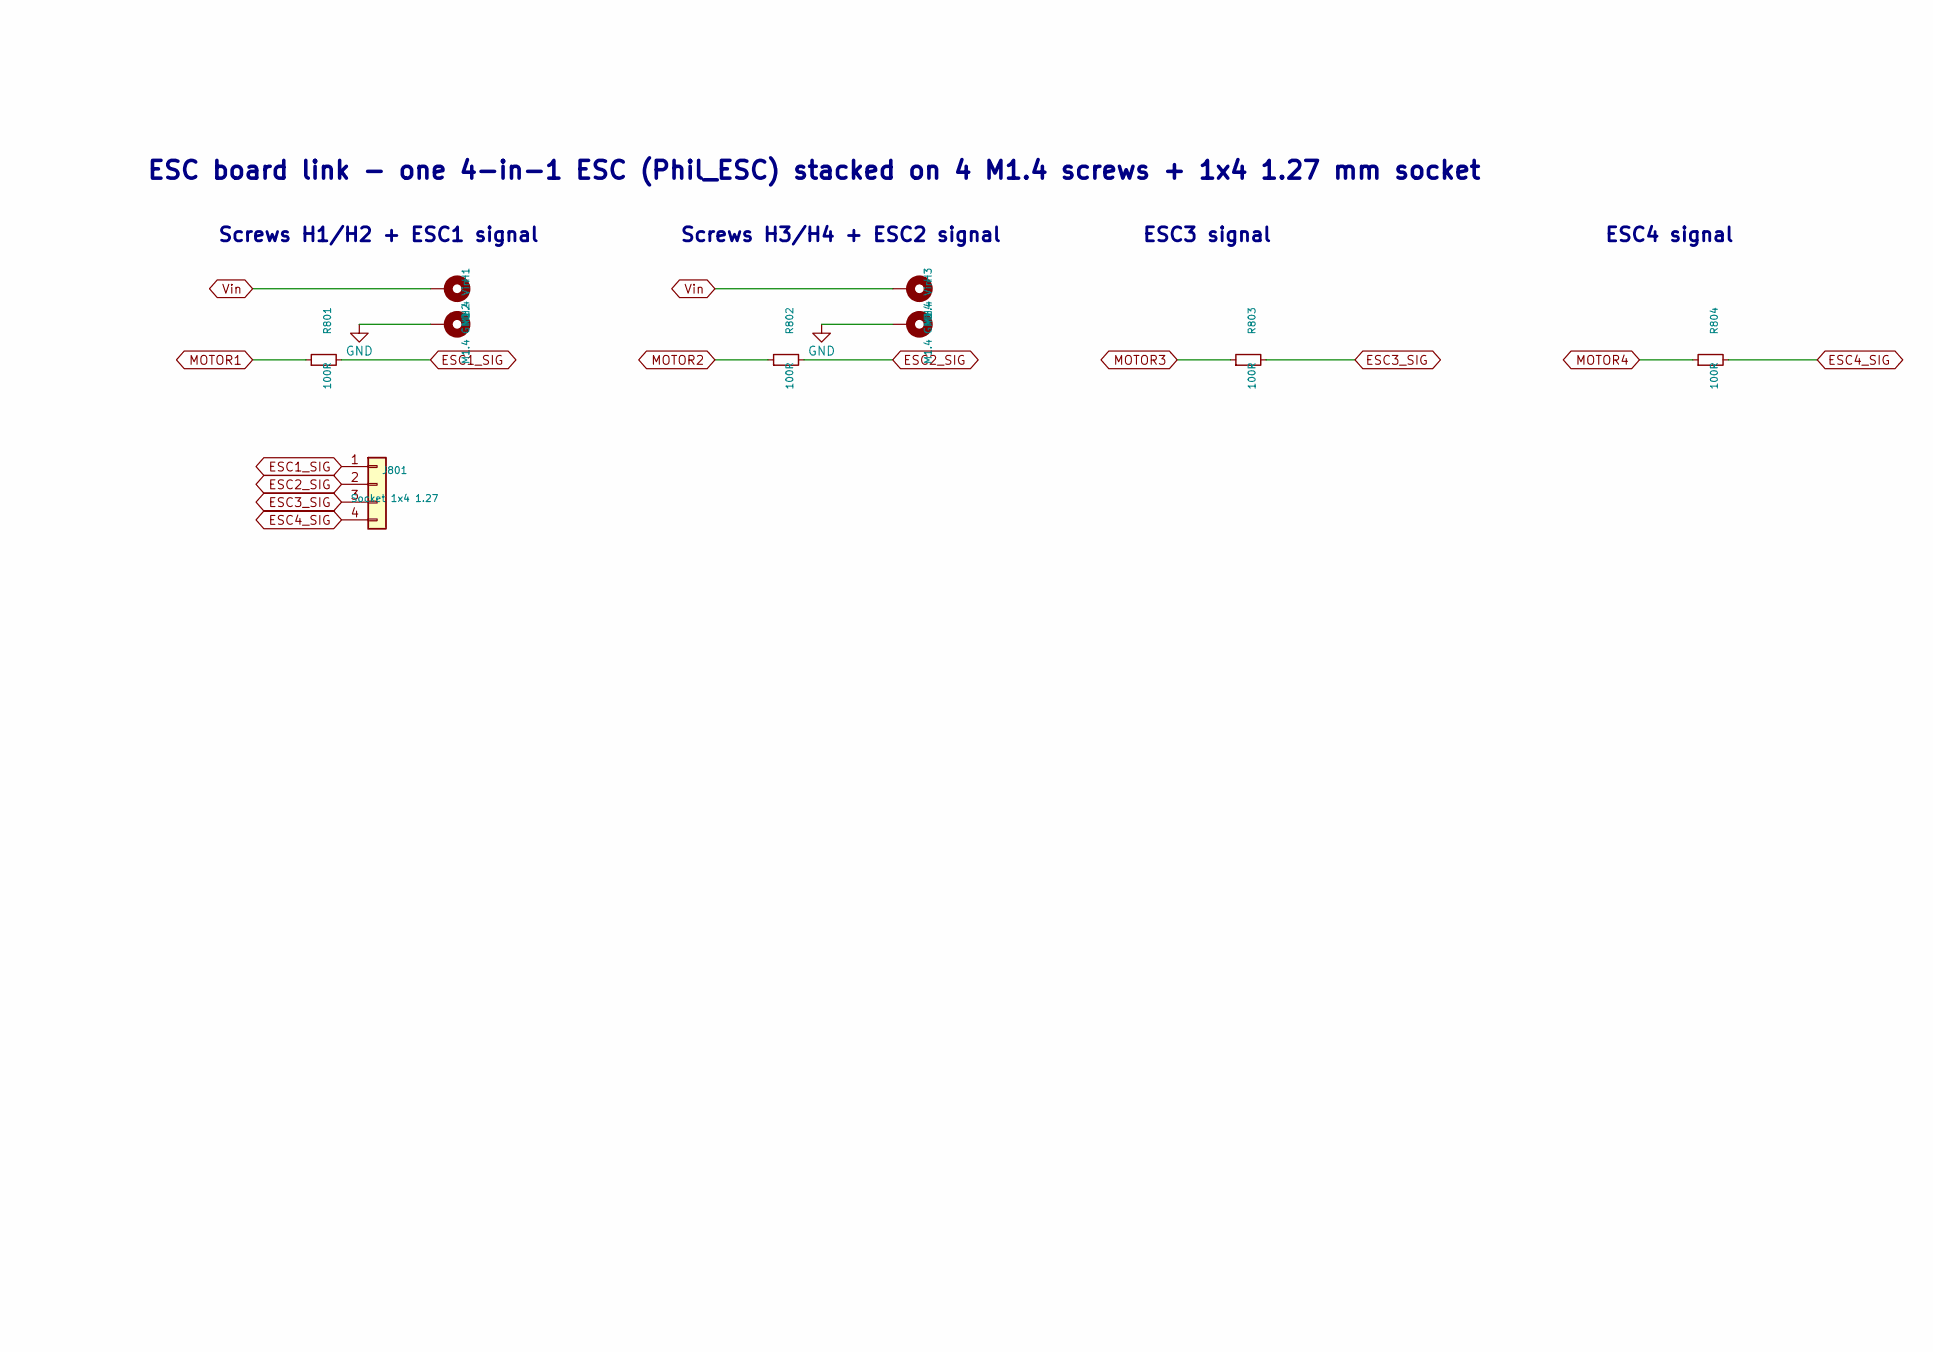
[picture p12: schematic Whoop_1S_FC.kicad_sch, 1S Whoop AIO Flight Controller, part in row 1, column 3]

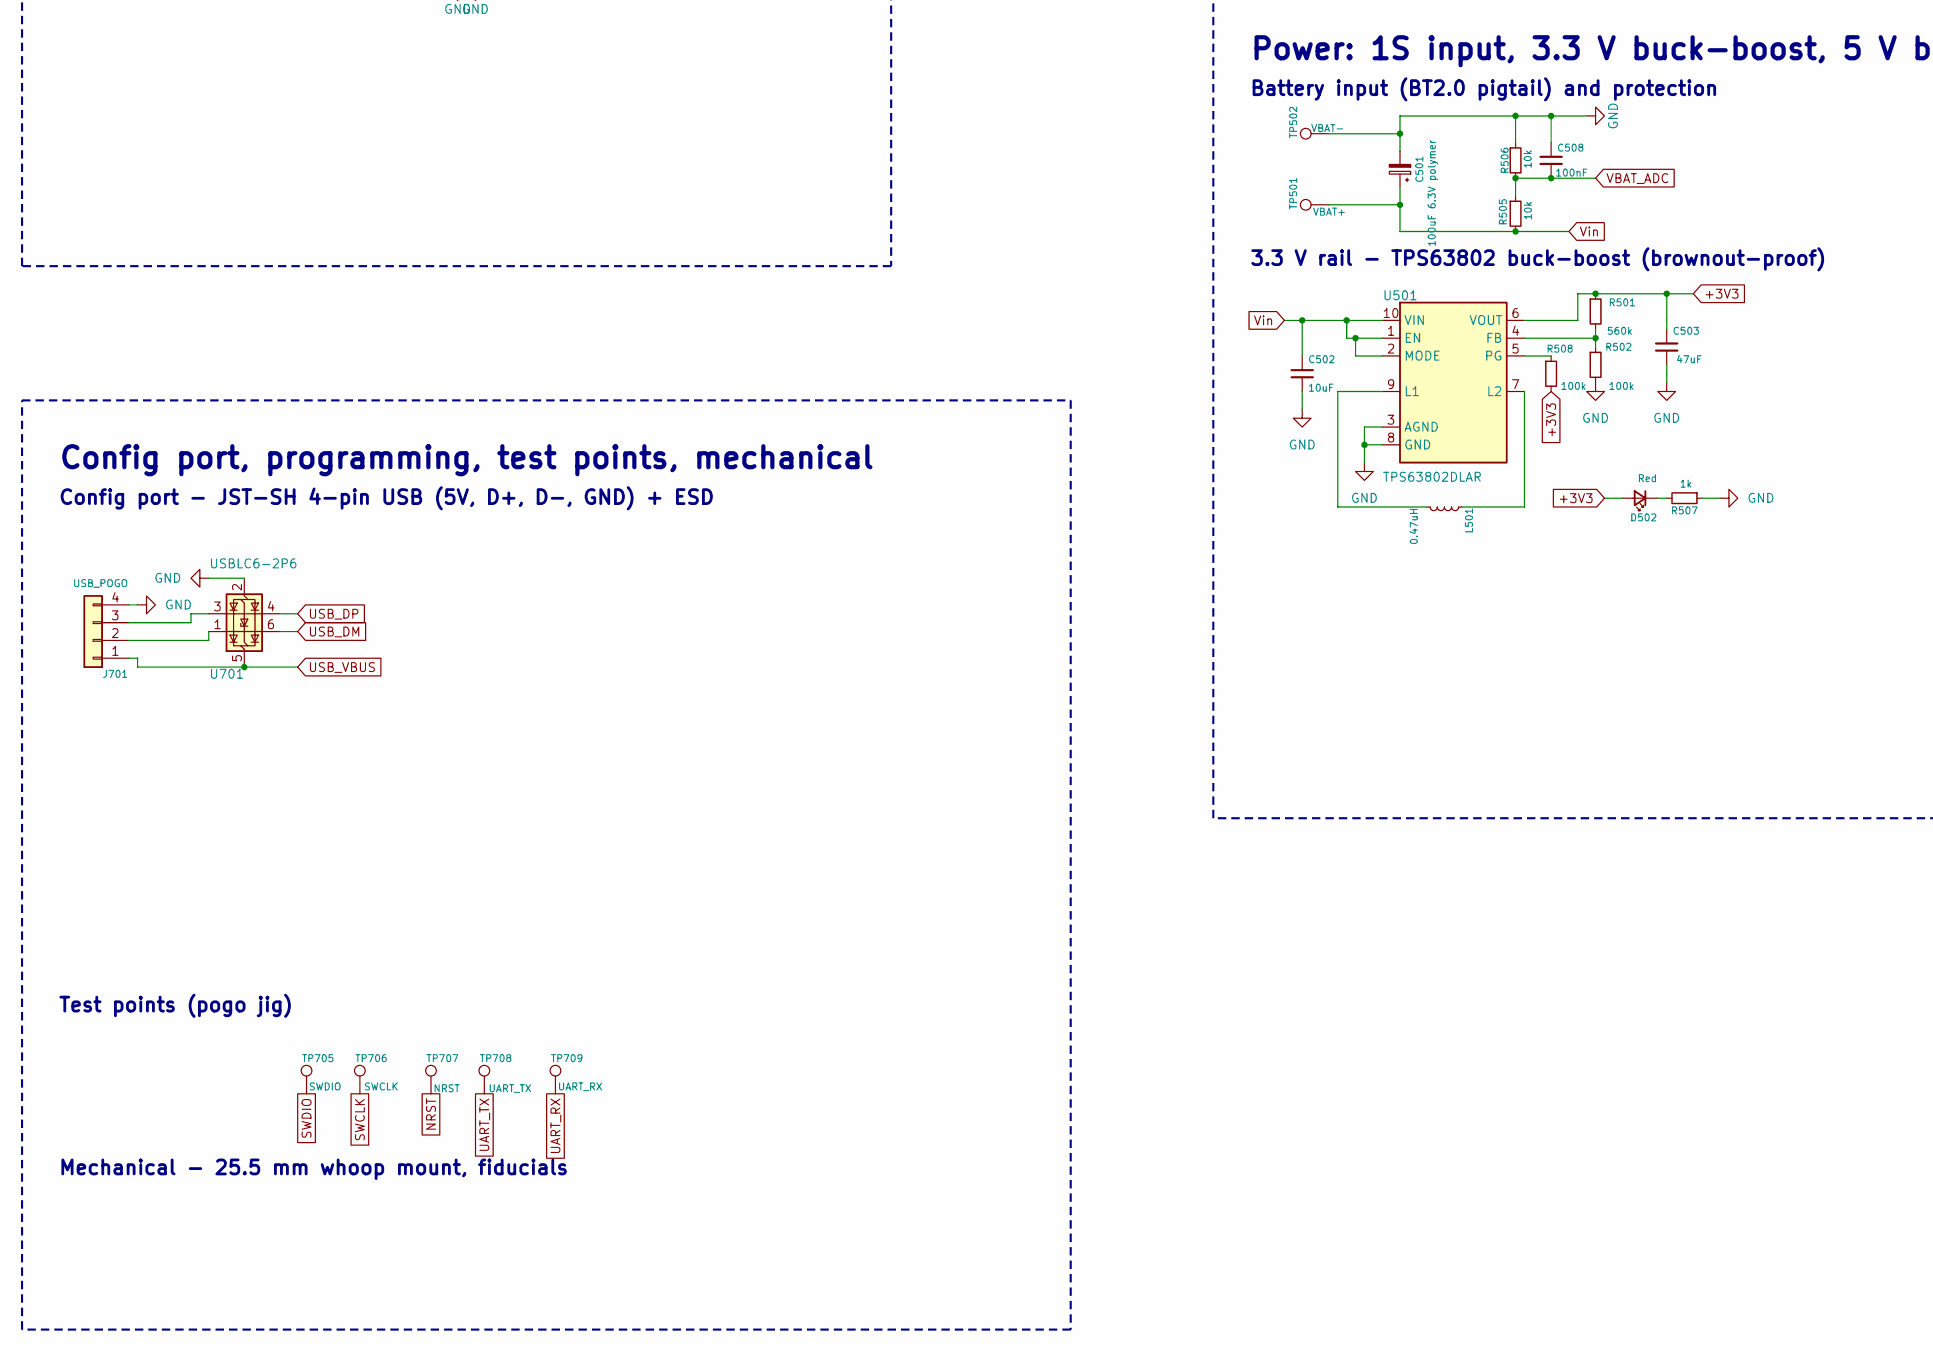
[picture p13: schematic Whoop_1S_FC.kicad_sch, 1S Whoop AIO Flight Controller, part in row 2, column 1]

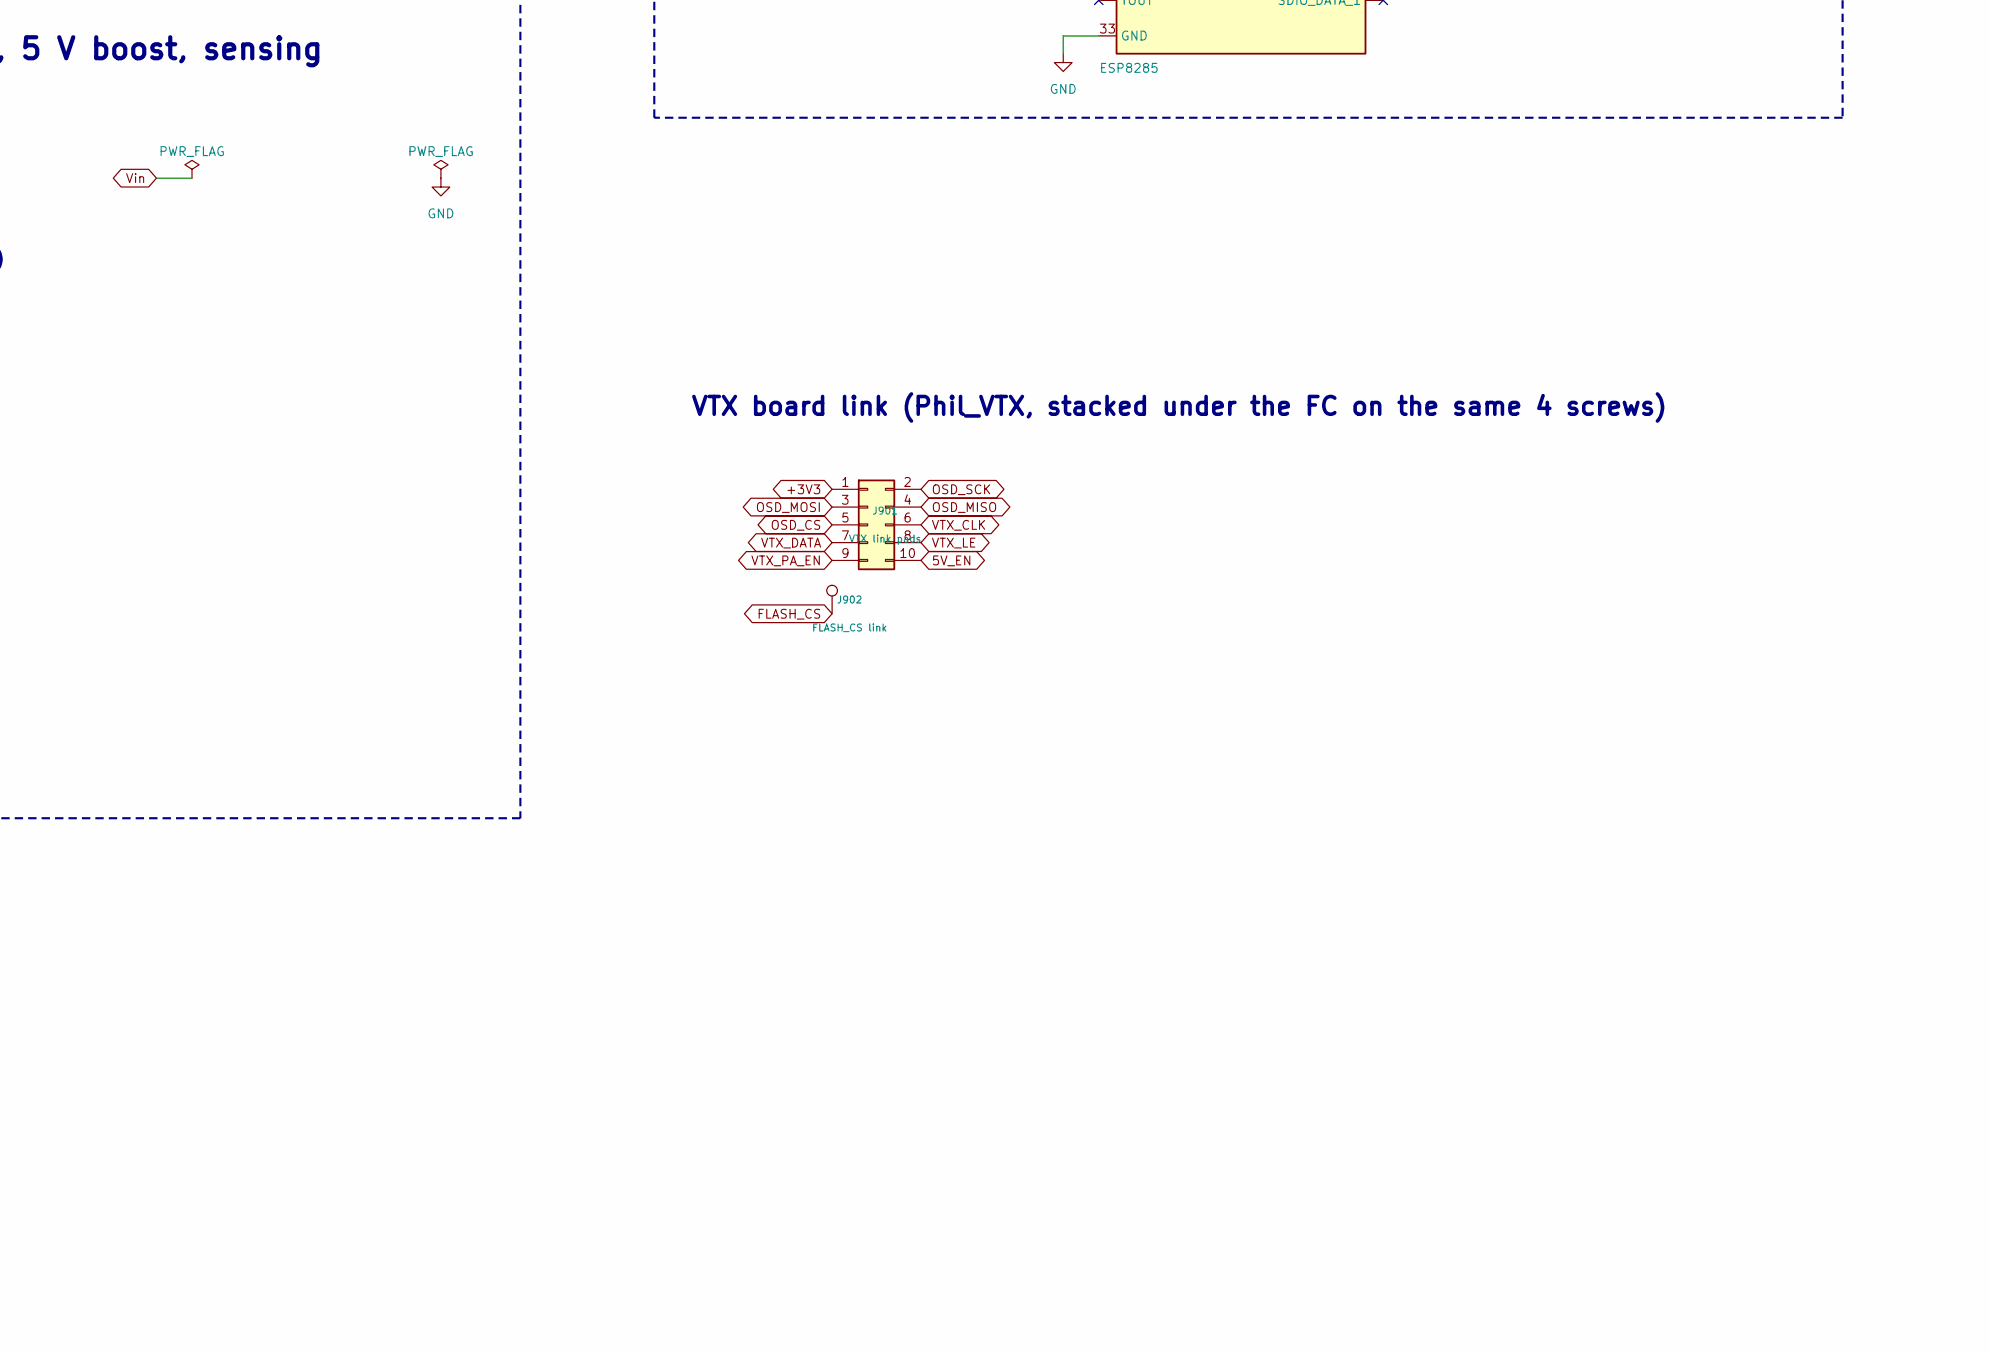
[picture p14: schematic Whoop_1S_FC.kicad_sch, 1S Whoop AIO Flight Controller, part in row 2, column 2]

Parts:
AE301: 2450AT18A100; Johanson_2450AT18x100; MPN 2450AT18A100
C101, C102, C324, C325: 10pF; C_0201_0603Metric; MPN GRM0335C1H100JA01D; LCSC C76921
C103, C104, C105, C106, C107, C110, C203, C205, C301, C303, C304, C314, C322, C508: 100nF; C_0201_0603Metric; MPN CL03A104KQ3NNNC; LCSC C160831
C108: 1uF; C_0201_0603Metric; MPN CL03A105MQ3CSNC; LCSC C170152
C201, C302, C308: 10nF; C_0201_0603Metric; MPN GRM033R71A103KA01D; LCSC C76941
C202: 2.2uF; C_0201_0603Metric; MPN CL03A225MQ3CRNC; LCSC C77762
C306: 470nF; C_0201_0603Metric; MPN CL03A474KQ3NNNC; LCSC C318543
C310, C318, C319, C320, C321: TBD; C_0201_0603Metric
C315, C502: 10uF; C_0603_1608Metric; MPN CL10A106KP8NNNC; LCSC C19702
C317: 1nF; C_0201_0603Metric; MPN GRM033R71E102KA01D; LCSC C76943
C501: 100uF 6.3V polymer; CP_EIA-3216-18_Kemet-A
C503: 47uF; C_0603_1608Metric; MPN GRM188R60J476ME15
D101: Blue; LED_0201_0603Metric
D102: Orange; LED_0201_0603Metric
D103: Yellow; LED_0201_0603Metric
D301: ESD131-B1-W0201; Infineon_SG-WLL-2-3_0.58x0.28_P0.36mm; MPN ESD131-B1-W0201
D302: Green; LED_0201_0603Metric
D502: Red; LED_0201_0603Metric
FB201: 600R@100MHz; L_0402_1005Metric
H1, H3: M1.4 Vin; MountingHole_1.6mm_M1.4_Pad_2.6mm
H2, H4: M1.4 GND; MountingHole_1.6mm_M1.4_Pad_2.6mm
J701: USB_POGO; Pogo_1x04_P1.27mm_D0.9mm; MPN SM04B-SRSS-TB
J801: Socket 1x4 1.27; PinSocket_1x04_P1.27mm_Vertical
J901: VTX link pads; Pads_2x05_P1.8mm_1.5x2.0mm
J902: FLASH_CS link; TP_Wire_1.5x2.0mm
L301: 15uH; L_0603_1608Metric
L302, L303: TBD; L_0201_0603Metric
L501: 0.47uH; L_Murata_DFE201610P
R101, R303, R308, R310, R505, R506: 10k; R_0201_0603Metric; MPN RC0201FR-0710KL; LCSC C106225
R102, R103, R104, R304, R507: 1k; R_0201_0603Metric; MPN 0201WMF1001TEE; LCSC C270365
R201, R202: 4.7k; R_0201_0603Metric; MPN 0201WMF4701TEE; LCSC C270346
R301: 12k 1%; R_0201_0603Metric; MPN RC0201FR-0712KL; LCSC C295719
R309: 499R; R_0201_0603Metric; MPN RC0201FR-07499RL; LCSC C138137
R501: 560k; R_0201_0603Metric; MPN RC0201DR-07560KL; LCSC C2111026
R502, R508: 100k; R_0201_0603Metric; MPN 0201WMF1003TEE; LCSC C270364
R801, R802, R803, R804: 100R; R_0201_0603Metric; MPN 0201WMF1000TEE; LCSC C270366
TP101: BOOT0; TP_Probe_D0.6mm
TP102: LED_STRIP; TP_Wire_1.5x2.0mm
TP301: BIND/BOOT; TP_Probe_D0.6mm
TP501: VBAT+; TP_Battery_1.5x2.2mm
TP502: VBAT-; TP_Battery_1.5x2.2mm
TP705: SWDIO; TP_Probe_D0.6mm
TP706: SWCLK; TP_Probe_D0.6mm
TP707: NRST; TP_Probe_D0.6mm
TP708: UART_TX; TP_Probe_D0.6mm
TP709: UART_RX; TP_Probe_D0.6mm
U101: STM32G473MEY6; ST_WLCSP-81_4.02x4.27mm_Layout9x9_P0.4mm; MPN STM32G473MEY6
U201: ICM-42688-P; Bosch_LGA-14_3x2.5mm_P0.5mm; MPN ICM-42688-P
U202: SPL06-001; Bosch_LGA-8_2x2.5mm_P0.65mm_ClockwisePinNumbering; MPN SPL06-001
U301: SX1281IMLTRT; QFN-24-1EP_4x4mm_P0.5mm_EP2.6x2.6mm; MPN SX1281IMLTRT
U302: ESP8285; QFN-32-1EP_5x5mm_P0.5mm_EP3.7x3.7mm; MPN ESP8285N08
U501: TPS63802DLAR; Texas_VSON-HR-10_2x3mm_P0.5mm_DLA0010A; MPN TPS63802DLAR
U701: USBLC6-2P6; SOT-666; MPN USBLC6-2SC6
Y101: 8MHz; Crystal_SMD_2016-4Pin_2.0x1.6mm
Y301: 52MHz TCXO; Oscillator_SMD_SiT_PQFN-4Pin_2.0x1.6mm
Y302: 26MHz; Crystal_SMD_WE_IQXC-26-4Pin_1.6x1.2mm

Connections:
5V_EN: J901.10, U101.C9 (PC14)
+3V3: C103.1, C104.1, C105.1, C106.1, C107.1, C108.1, C201.1, C202.2, C203.2, C205.1, C303.2, C304.1, C314.2, C315.1, C322.2, C503.1, D502.2 (A), FB201.1, J901.1, R102.1, R103.1, R104.1, R201.2, R202.2, R303.1, R308.2, R501.1, R508.2, U101.A1 (VDD), U101.A9 (VDD), U101.B9 (VBAT), U101.E1 (VDD), U101.J1 (VDD), U101.J5 (VDDA), U101.J6 (VREF+), U101.J9 (VDD), U201.5 (VDDIO), U201.8 (VDD), U202.2 (CSB), U202.6 (VDDIO), U202.8 (VDD), U301.11 (VBAT_IO), U301.15 (VBAT), U302.1 (VDDA), U302.3 (VDD3P3), U302.4 (VDD3P3), U302.11 (VDDPST), U302.17 (VDDPST), U302.29 (VDDD), U302.30 (VDDA), U501.6 (VOUT)
BARO_SCK: R202.1, U101.C5 (PC8), U202.4 (SCK)
BARO_SDA: R201.1, U101.C4 (PC11), U202.3 (SDI/SDA)
ESC1_SIG: J801.1, R801.2
ESC2_SIG: J801.2, R802.2
ESC3_SIG: J801.3, R803.2
ESC4_SIG: J801.4, R804.2
FLASH_CS: J902.1, U101.H2 (PB11)
GND: C101.2, C102.2, C103.2, C104.2, C105.2, C106.2, C107.2, C108.2, C110.2, C201.2, C202.1, C203.1, C205.2, C301.2, C302.1, C303.1, C304.2, C306.2, C308.2, C314.1, C315.2, C318.1, C320.1, C321.1, C322.1, C324.2, C325.2, C501.2, C502.2, C503.2, C508.1, D301.2 (A2), H2.1, H4.1, J701.4, R101.2, R301.1, R304.2, R310.2, R502.2, R506.1, R507.1, TP502.1 (1_1), U101.A8 (VSS), U101.B1 (VSS), U101.F1 (VSS), U101.H6 (VSSA), U101.H9 (VSS), U101.J2 (VSS), U201.2 (RESV), U201.3 (RESV), U201.6 (GND), U201.7 (RESV), U201.10 (RESV), U201.11 (RESV), U202.1 (GND), U202.5 (SDO), U202.7 (GND), U301.5 (GND), U301.13 (GND), U301.20 (GND), U301.21 (GND), U301.23 (GND), U301.24 (GND), U301.25 (GND(EP)), U302.33 (GND), U501.3 (AGND), U501.8 (GND), U701.2 (GND), Y101.2 (G), Y101.4 (G), Y301.2 (GND), Y302.2 (G), Y302.4 (G)
GYRO_CS: U101.A4 (PD1), U201.12 (AP_CS)
GYRO_INT1: U101.A3 (PC12), U201.4 (INT1/INT)
GYRO_INT2: U101.B6, U201.9 (INT2/FSYNC/CLKIN)
GYRO_SCL: U101.A5 (PB3), U201.13 (AP_SCL/AP_SCLK)
GYRO_SDA: U101.A6 (PB5), U201.14 (AP_SDA/AP_SDIO/AP_SDI)
GYRO_SDO: U101.C6 (PB4), U201.1 (AP_SDO/AP_AD0)
LED_STRIP: TP102.1 (1_1), U101.J8 (PA7)
MOTOR1: R801.1, U101.F5 (PE9)
MOTOR2: R802.1, U101.H4 (PE11)
MOTOR3: R803.1, U101.G4 (PE13)
MOTOR4: R804.1, U101.J3 (PE14)
NRST: C110.1, TP707.1 (1_1), U101.D8 (PG10)
unnamed: AE301.1 (FEED_1), C310.2, D301.1 (A1)
unnamed: C310.1, C318.2, C319.2, L303.2
unnamed: C319.1, C320.2, L302.2, L303.1
unnamed: D101.2 (A), R102.2
unnamed: D101.1 (K), U101.A7 (PB9)
unnamed: D102.2 (A), R103.2
unnamed: D102.1 (K), U101.C7 (PB7)
unnamed: D103.2 (A), R104.2
unnamed: D103.1 (K), U101.B5 (PD2)
unnamed: D302.2 (A), U302.8 (XPD_DCDC/GPIO16)
unnamed: D302.1 (K), R304.1
unnamed: D502.1 (K), R507.2
unnamed: J701.2, U701.1 (I/O1)
unnamed: J701.3, U701.3 (I/O2)
unnamed: R101.1, TP101.1 (1_1), U101.B7 (PB8)
unnamed: C101.1, U101.E9 (PF0), Y101.1
unnamed: C102.1, U101.F9 (PF1), Y101.3
unnamed: C306.1, C308.1, L301.1, U301.2 (VDD_IN), U301.12 (DCC_FB)
unnamed: L301.2, U301.14 (DCC_SW)
unnamed: C321.2, L302.1, U301.22 (RFIO)
unnamed: C302.2, U301.1 (VR_PA)
unnamed: C317.2, U301.4 (XTA)
unnamed: R303.2, U302.7 (CHIP_EN)
unnamed: R308.1, TP301.1 (1_1), U302.15 (GPIO0)
unnamed: R301.2, U302.31 (RES12K)
unnamed: R309.1, U302.26 (U0TXD/GPIO1)
unnamed: C324.1, U302.28 (XTAL_IN), Y302.1
unnamed: C325.1, U302.27 (XTAL_OUT), Y302.3
unnamed: R501.2, R502.1, U501.4 (FB)
unnamed: L501.2, U501.9 (L1)
unnamed: L501.1, U501.7 (L2)
unnamed: R508.1, U501.5 (PG)
unnamed: C317.1, Y301.3 (OUT)
unnamed: C301.1, FB201.2, Y301.4 (VCC)
OSD_CS: J901.5, U101.G3 (PB12)
OSD_MISO: J901.4, U101.G2 (PB14)
OSD_MOSI: J901.3, U101.E4 (PB15)
OSD_SCK: J901.2, U101.H1 (PB13)
RX_BUSY: U301.7 (BUSY), U302.24 (GPIO5)
RX_DIO1: U301.8 (DIO1), U302.16 (GPIO4)
RX_MISO: U301.16 (MISO_TX), U302.10 (MTDI/GPIO12)
RX_MOSI: U301.17 (MOSI_RX), U302.12 (MTCK/GPIO13)
RX_NRESET: U301.3 (NRESET), U302.14 (GPIO2)
RX_NSS: R310.1, U301.19 (NSS_CTS), U302.13 (MTDO/GPIO15)
RX_RX: R309.2, U101.H8 (PA3)
RX_SCK: U301.18 (SCK_RTSN), U302.9 (MTMS/GPIO14)
RX_TX: U101.G8 (PA2), U302.25 (U0RXD/GPIO3)
SWCLK: TP706.1 (1_1), U101.C3 (PA14)
SWDIO: TP705.1 (1_1), U101.B2 (PA13)
UART_RX: TP709.1, U101.D3 (PA10)
UART_TX: TP708.1, U101.D4 (PA9)
USB_DM: U101.C2 (PA11), U701.6 (I/O1)
USB_DP: U101.C1 (PA12), U701.4 (I/O2)
USB_VBUS: J701.1, U701.5 (VBUS)
VBAT_ADC: C508.2, R505.1, R506.2, U101.D7 (PA0)
VTX_CLK: J901.6, U101.F7 (PA5)
VTX_DATA: J901.7, U101.J7 (PB2)
VTX_LE: J901.8, U101.G7 (PA6)
VTX_PA_EN: J901.9, U101.D6 (PA4)
Vin: C501.1, C502.1, H1.1, H3.1, R505.2, TP501.1 (1_1), U501.1 (EN), U501.2 (MODE), U501.10 (VIN)

Notes on the sheet:
Mechanical - 25.5 mm whoop mount, fiducials
Flight controller MCU
Config port, programming, test points, mechanical
Gyro, barometer, Blackbox flash
STM32G473MEY6 (WLCSP-81) - Betaflight STM32G47X target
3.3 V rail - TPS63802 buck-boost (brownout-proof)
Power: 1S input, 3.3 V buck-boost, 5 V boost, sensing
ESP8285 ELRS MCU + 26 MHz crystal
Test points (pogo jig)
Barometer - SPL06-001 (DPS310 pin-compatible alt), I2C
Config port - JST-SH 4-pin USB (5V, D+, D-, GND) + ESD
ELRS 2.4 GHz receiver (SX1281 + ESP8285, CRSF over UART)
Gyro / IMU - ICM-42688-P on its own SPI bus (BMI270 = alt, different pinout)
Screws H1/H2 + ESC1 signal
SX1281 radio + 52 MHz TCXO
ESC3 signal
VTX board link (Phil_VTX, stacked under the FC on the same 4 screws)
Screws H3/H4 + ESC2 signal
Decoupling: each cap goes on the bottom side under the VDD/VSS ball pair named in its Description.
ESC board link - one 4-in-1 ESC (Phil_ESC) stacked on 4 M1.4 screws + 1x4 1.27 mm socket
ESC4 signal
Battery input (BT2.0 pigtail) and protection
Blackbox flash - W25Q128JV 16 MB (shared SPI with OSD)

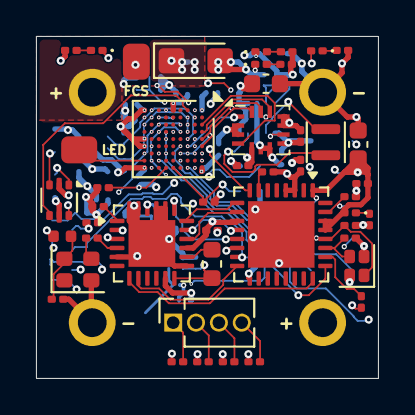
[picture p15: board Whoop_1S_FC.kicad_pcb from above]

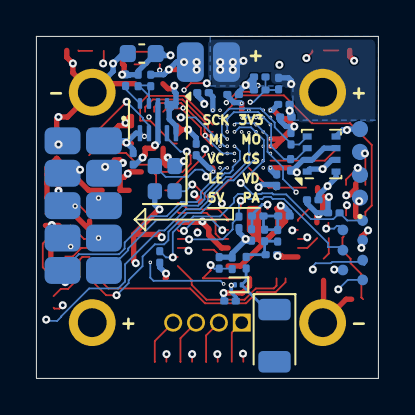
[picture p16: board Whoop_1S_FC.kicad_pcb from below]

Board: 6 copper layers, 19.0 x 19.0 mm, 96 parts (46 on the bottom side), 82 nets.
